aaaaaaaalesha/wdt_agent/documentation/РПЗ. Сторожевой таймер. ИУ8-74 Александров.pdf

Министерство науки и высшего образования Российской Федерации Федеральное государственное бюджетное образовательное учреждение высшего образования
«Московский государственный технический университет имени Н.Э. Баумана
(национальный исследовательский университет)» (МГТУ им. Н.Э. Баумана)
ФАКУЛЬТЕТ | Информатика и системы управления (ИУ)
КАФЕДРА | Информационная безопасность (ИУ8)

## РАСЧЕТНО-ПОЯСНИТЕЛЬНАЯ ЗАПИСКА

## К КУРСОВОМУПРОЕКТУ

## НА ТЕМУ:

## Система восстановления работоспособности терминала самообслуживания

Студент | ИУ8-74 | А. Н. Александров
(Группа) | (Подпись, дата) | (И.О.Фамилия)
Руководитель курсового проекта | А. Г. Рафиков
(Подпись, дата) | (И.О.Фамилия)

Консультант
(Подпись, дата) | (И.О.Фамилия)

Министерство науки и высшего образования Российской Федерации Федеральное государственное бюджетное образовательное учреждение высшего образования
«Московский государственный технический университет имени Н.Э. Баумана (национальный исследовательский университет)» (МГТУ им. Н.Э. Баумана)

УТВЕРЖДАЮ

Заведующий кафедрой ИУ-8
(Индекс)
______________ М.А.Басараб
(И.О.Фамилия)
«_____» сентября 2022 г.

### З А Д А Н И Е

на выполнение курсовой работы

по дисциплине | Аппаратные средства вычислительной техники
Студент группы ИУ8-74
Александров Алексей Николаевич
(Фамилия, имя, отчество)
Тема курсовой работы Разработка системы восстановления работоспособности

Направленность КР (учебная, исследовательская, практическая, производственная, др.)

учебная

Источник тематики (кафедра, предприятие, НИР) | кафедра
График выполнения КР: | 25% к 4 нед., 50% к 7 нед., 75% к 10 нед., 100% к 14 нед.
Оформление курсовой работы:
- Техническое задание.
- Расчетно-пояснительная записка на листах формата А4.
Перечень графического (иллюстративного) материала (чертежи, плакаты, слайды и т.п.)
1. Схема электрическая структурная
2. Схема электрическая принципиальная

Дата выдачи задания « » сентября 2022 г.

Студент | _________________ | А.Н. Александров
| (Подпись, дата) | (И.О.Фамилия)
Руководитель курсовой работы | _________________ | А.Г. Рафиков
| (Подпись, дата) | (И.О.Фамилия)
Примечание: Задание оформляется в двух экземплярах: один выдается студенту, второй хранится на кафедре.

СОДЕРЖАНИЕ

ПРИЛОЖЕНИЕ Г – СХЕМА ЭЛЕКТРИЧЕСКАЯ ПРИНЦИПИАЛЬНАЯ20

ВВЕДЕНИЕ

Мы всегда надеемся, что оборудование и инфраструктура будут работать

чётко, надёжно, и без поломок. Особенно это важно там, где неисправности

приводят к остановке бизнес–процессов и как следствие – финансовым

потерям.

Как минимум, эти потери складываются из оплаты сотрудников за время

простоя (пока они ждут восстановления работы системы), и упущенной за это

время прибыли. К этому можно добавить суммы, затраченные на сам ремонт и

восстановление системы (покупку исправных комплектующих, оплату работ по

установке и замене, и т.п.). Сумма убытков может быть достаточно большой; в

некоторых случаях простой может привести к непоправимым последствиям –

вплоть до исчезновения бизнеса. Это является поводом задуматься о том, как

можно избежать остановки работоспособности.

Сторожевой таймер (от англ. WatchDog Timer) – аппаратно реализованная

схема контроля над зависанием системы. Представляет собой таймер, который

периодически сбрасывается контролируемой системой. Если сброса не

произошло | в | течение | некоторого | интервала | времени, | происходит

принудительная перезагрузка системы.

НАЗНАЧЕНИЕ И ОБЛАСТЬ ПРИМЕНЕНИЯ

Задача системы – восстанавливать работоспособность терминала

самообслуживания и программного обеспечения, запущенного на нём, при

зависаниях для обеспечения её надёжности и безотказной работы. В случае

непредвиденной ошибки и зависания ОС и ПО, сторожевой таймер не получит

сигнала обновления таймера и выполнит принудительную перезагрузку

системы или перезапуск приложения соответственно.

Областью применения является терминал самообслуживания. Это

специализированное электронно-механическое устройство, которое позволяет

автоматизировать процессы. С помощью таких устройств пользователь может

без участия сотрудника оплатить покупки, получить посылку, пройти через

турникет или оплатить услуги. Примеры аппаратов самообслуживания: кассы

самообслуживания, постаматы, информационные терминалы и вендинговые

автоматы (см. рисунок 1).

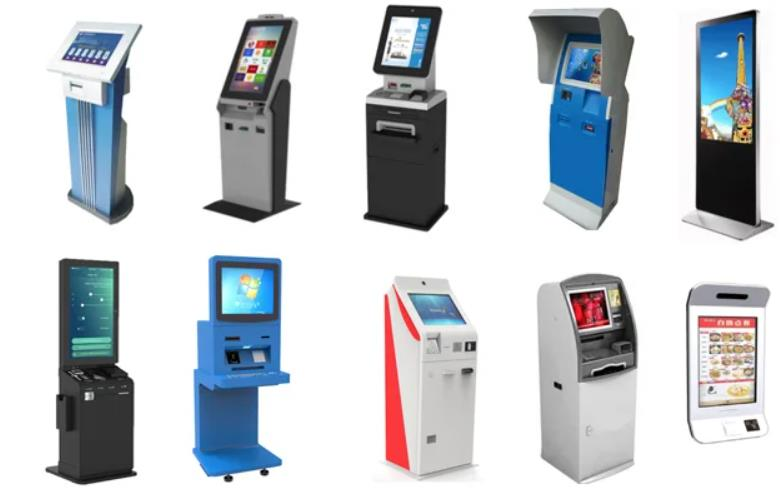
[picture p2: figure]

Рисунок 1 – Примеры терминалов самообслуживания

Основная цель создания системы – разработка механизма безопасности,

который позволяет вернуть терминал самообслуживания и программное

обеспечение, запущенное на нём, в рабочий режим случае сбоя для повышения

её надёжности и безотказной работы.

ТЕХНИЧЕСКИЕ ХАРАКТЕРИСТИКИ

### 1 Аппаратная часть

### 1.1 Описание схемы

В ходе выполнения курсового проекта в соответствии с техническим

заданием были спроектированы схема электрическая структурная, схема

электрическая принципиальная и перечень элементов (ГОСТ 2.701 - 84). Схемы

можно видеть на рисунках 2 и 3, приложениях В и Г, а также в приложенной

документации к курсовому проекту. Перечень элементов – в приложении Ж и в

документации.

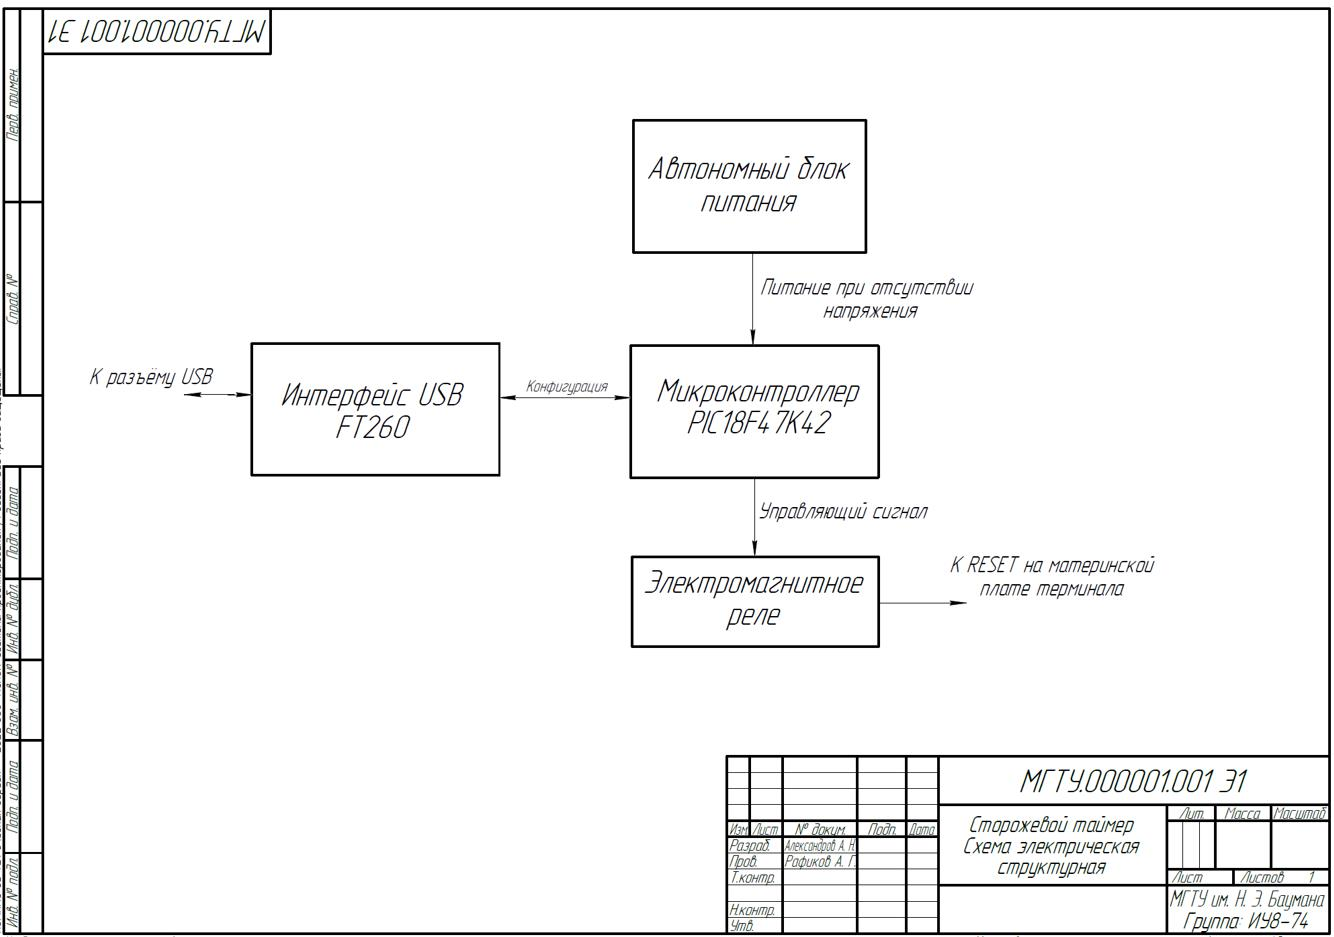
[picture p3: figure]

Рисунок 2 – Схема электрическая структурная (Э1)

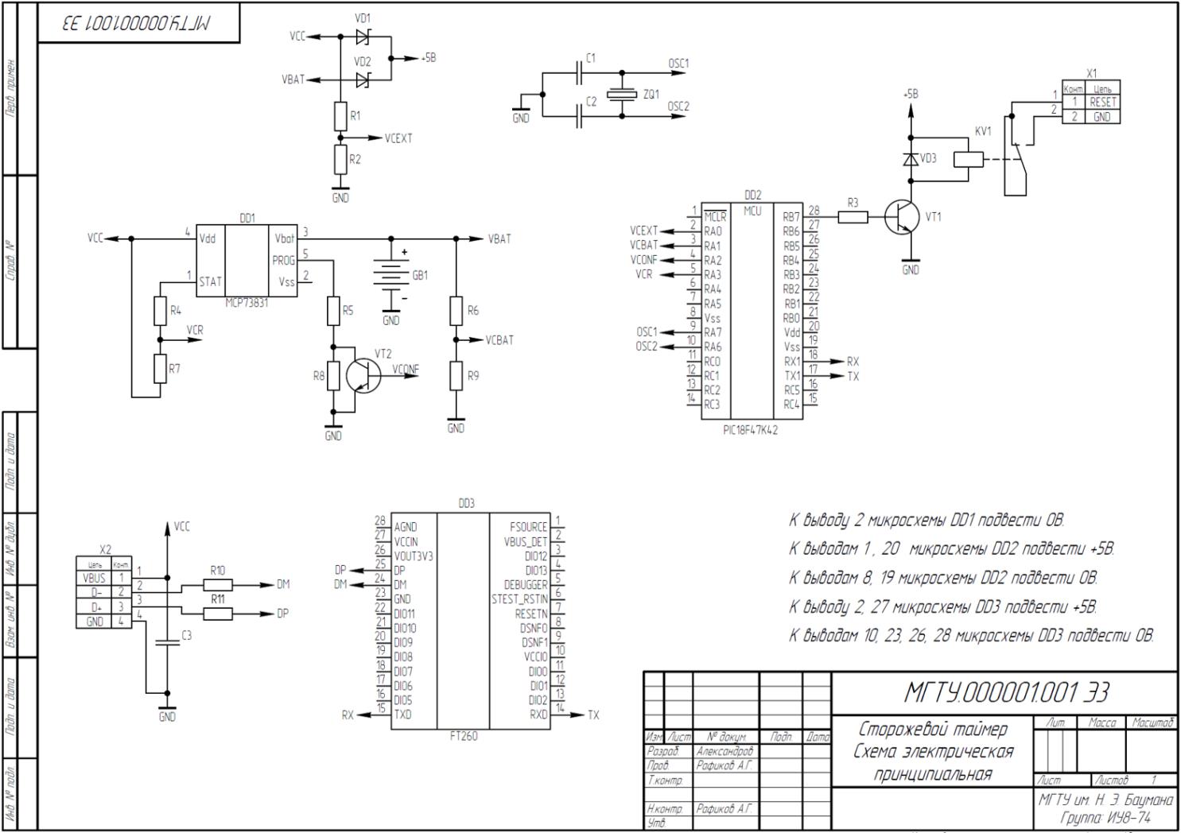
[picture p4: figure]

Рисунок 3 – Схема электрическая принципиальная (Э3)

В предложенной схеме в качестве основных компонентов выступают:

- микроконтроллер PIC18F47К42;
- герконовое реле EDR301A0500 для передачи сигнала RESET на

материнскую плату терминала самообслуживания и перезапуска

ОС;

- микросхема | FT260 | как | интерфейс | взаимодействия

микроконтроллера с USB;

- микросхема контроллера заряда MCP73831 для автономного блока

питания.

Также на схеме присутствуют элемент питания, NPN-транзисторы, диоды

Шоттки, кварцевый резонатор, а также резисторы и конденсаторы.

### 1.2 Обоснование выбора контроллера

В | качестве | микроконтроллера | был | выбран | восьмиразрядный

микроконтроллер PIC18F47К42. Некоторые технические характеристики:

- рабочая скорость: до 64 МГц;
- 128 Кб флеш-памяти, 8 Кб SRAM;
- диапазон рабочих напряжений: от 2.3 В до 5.5 В;
- диапазон рабочих температур: от -40°C до 85°C;
- оптимизированная компилятором C архитектура RISC.

Ключевыми факторами выбора можно назвать относительно низкую

стоимость, запас по программной памяти, скорость работы, что является

немаловажными критериями для данного класса устройств.

### 1.3 Обоснование выбора резисторов и конденсаторов

Элементы активного и реактивного сопротивления, включенные в схему,

выбраны из-за их невысокой стоимости. Также элементы SMD обладают рядом

существенных преимуществ, среди которых:

1. лучшая устойчивость к механическим поломкам вследствие вибрации;
2. небольшие погрешности при монтаже исправляются автоматически

поверхностным натяжением расплавленного олова или свинца;

3. нет необходимости сверлить отверстия и в том числе, как следствие,

более низкая начальная стоимость производства (экономический

| эффект);
4. небольшие размеры;
5. из-за малых размеров и монтирования в оной плоскости облегчается

двухслойная разводка.

### 1.4 Печатная плата и сборочный чертёж

Исходя из специфики устройства и его установки, был выбран корпус

G535B-2% — пластиковый корпус из ABS пластика, чертёж которого

представлен на рисунке 4. | Габаритные размеры составляют: по длине 114 мм,
по ширине 35,7 мм и по высоте 25,8 мм. | Размеры корпуса, расположение

диагональных отверстий и их диаметр были использованы для проектирования

и создания печатной платы, которая сможет быть в нём размещена.

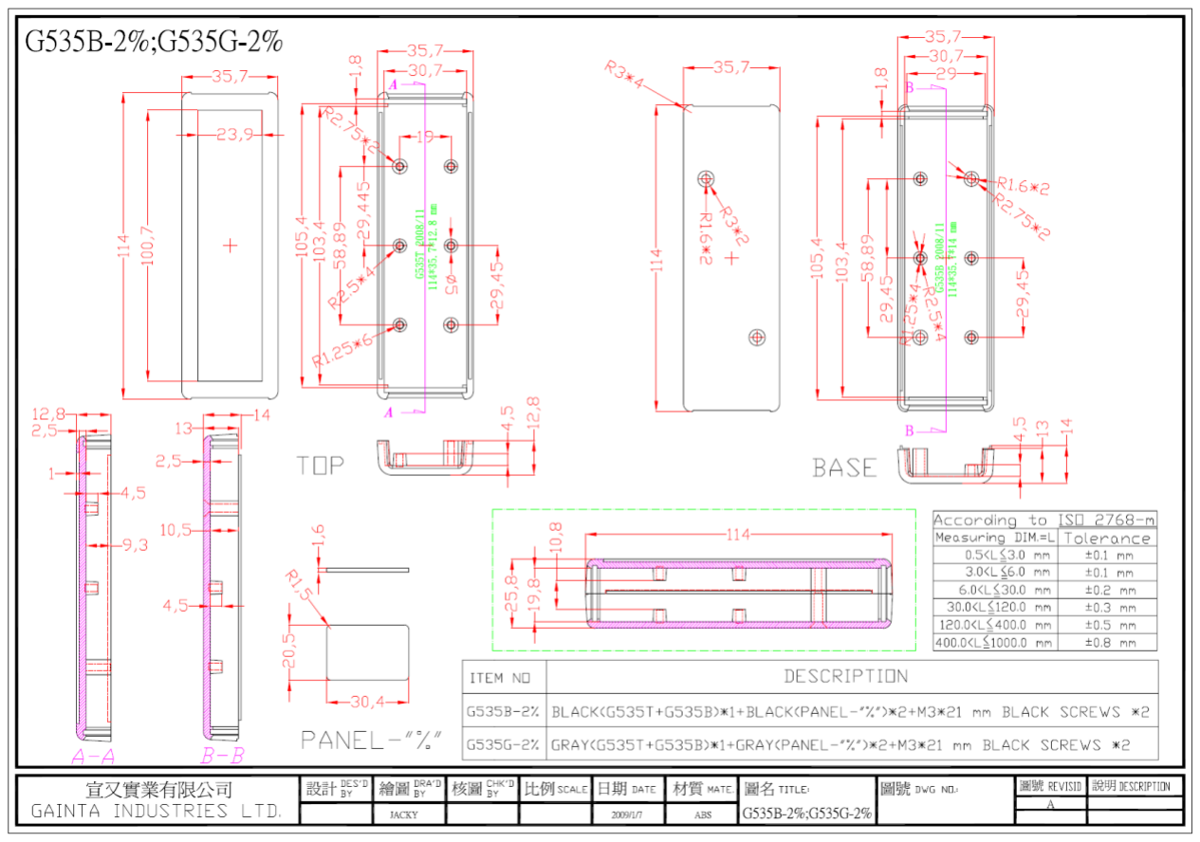
[picture p5: figure]

Рисунок 4 – Чертёж корпуса G535B-2%

Для проектирование и разводки печатной платы было использовано

САПР Autodesk Eagle, который предоставляет редактор схем и печатных плат с

невысоким порогом вхождения и простым и понятным интерфейсом. Далее

были выделены необходимые слои: верхний слой, нижний слой и слой

переходных отверстий, которые были перенесены в КОМПАС для создания

чертежа печатной платы в соответствии с ГОСТ (см рисунки 5 и 6).

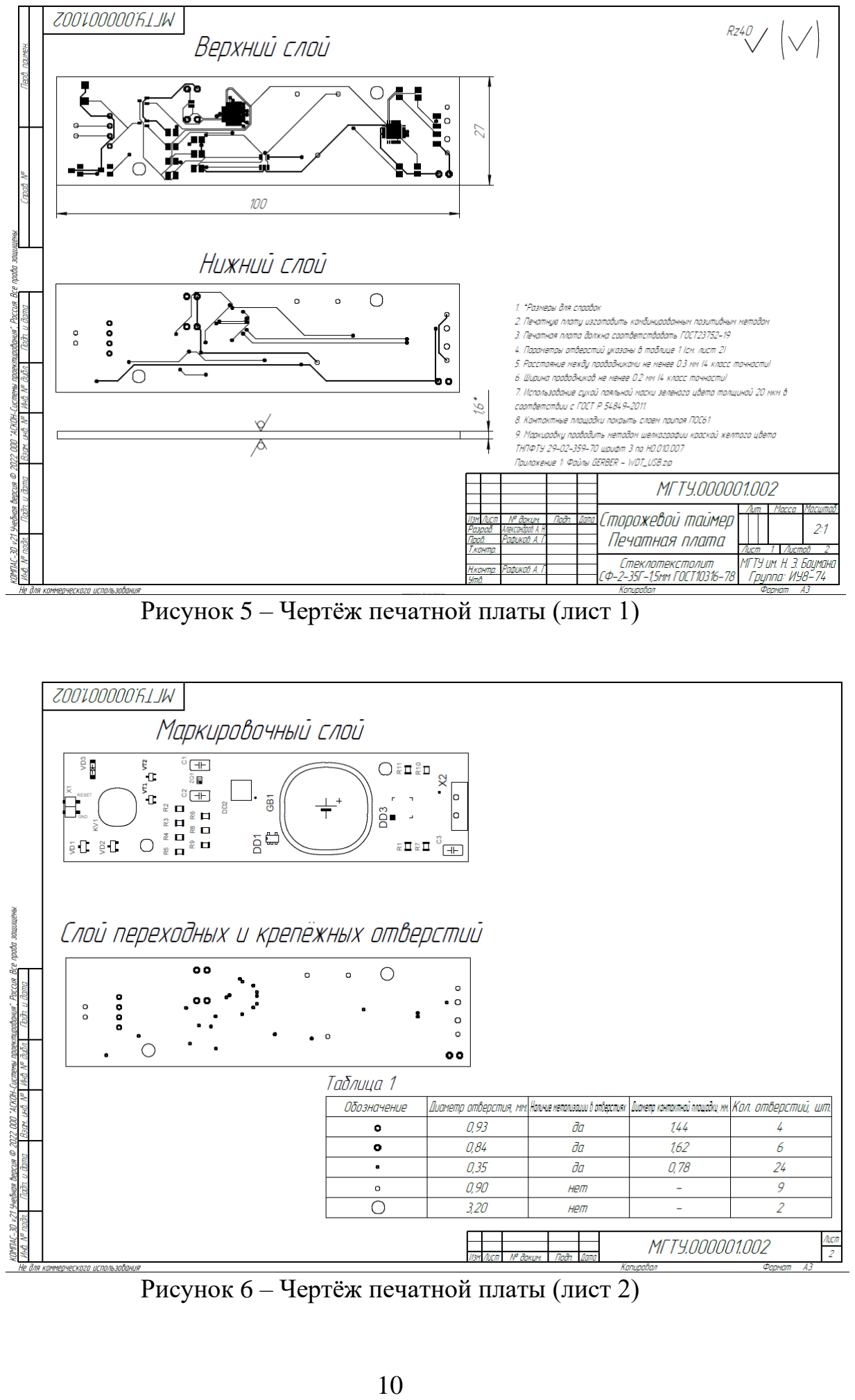
[picture p6: page 10]

Рисунок 5 – Чертёж печатной платы (лист 1)

Рисунок 6 – Чертёж печатной платы (лист 2)

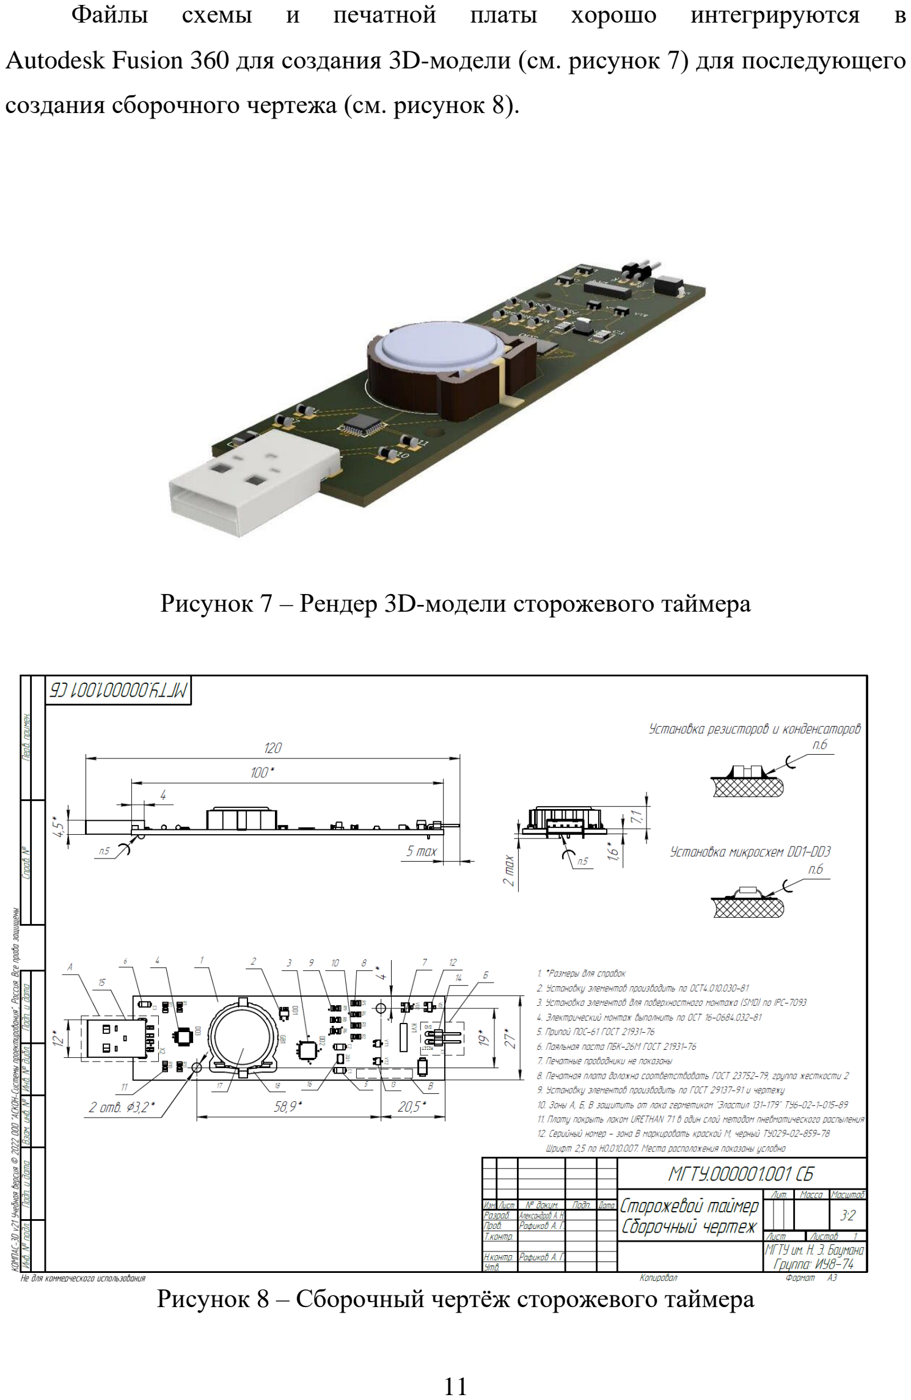
[picture p7: page 11]

Файлы | схемы | и | печатной | платы | хорошо | интегрируются | в

Autodesk Fusion 360 для создания 3D-модели (см. рисунок 7) для последующего

создания сборочного чертежа (см. рисунок 8).

Рисунок 7 – Рендер 3D-модели сторожевого таймера

Рисунок 8 – Сборочный чертёж сторожевого таймера

### 2 Программная часть

### 2.1 Описание программной части

Программная часть опытного образца представляет собой программное

обеспечение, которое также реализует работу с микроконтроллером.

Программный агент, будучи подключенным к сторожевому таймеру, посылает

сигналы сброса, в случае, когда эти сигналы не поступают, происходит

переключение реле и подача напряжения на сигнал RESET на материнской

плате.

### 2.2 Программный агент для терминала самообслуживания

Для создания программы-агента, работающего с моделью сторожевым

таймером был использован язык программирования Python. Десктопное

приложение работает под ОС Windows, которая распространена в данной

области | применения. | Программа-агент | осуществляет | подключение | к
устройству | по | COM-порту, | конфигурирование | таймера | и | занесение
приложений | в | список | отслеживаемых | процессов, | которые | следует

перезапускать в случае зависания (см. рисунок 9).

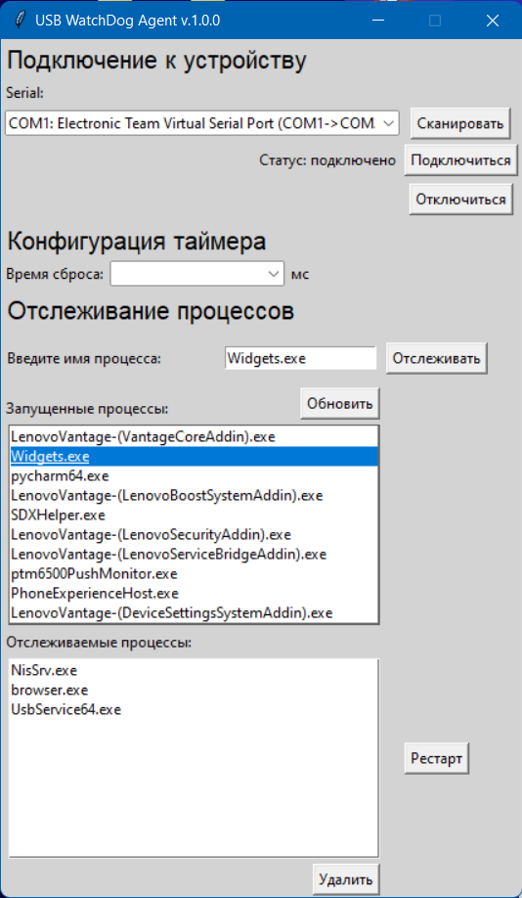
[picture p8: figure]

Рисунок 9 – Окно программы WatchDog Agent v.1.0.0

### 2.3 Программное обеспечение для сторожевого таймера

Исходным | языком | программирования | для | сторожевого | таймера

является Си. Программа обеспечивает взаимодействие с программой-агентом,

получение конфигурационных данных от него и переключение реле при

истечении таймаута и необходимости передачи управляющего сигнала RESET

на соответствующий пин. Моделирование производилось в среде Proteus (см.

рисунок 10). Создание пары виртуального COM-порта велось через Virtual

Driver Pro (см. рисунок 11). Таким образом можно производить подключение

программно к одному и тому же COM-порту.

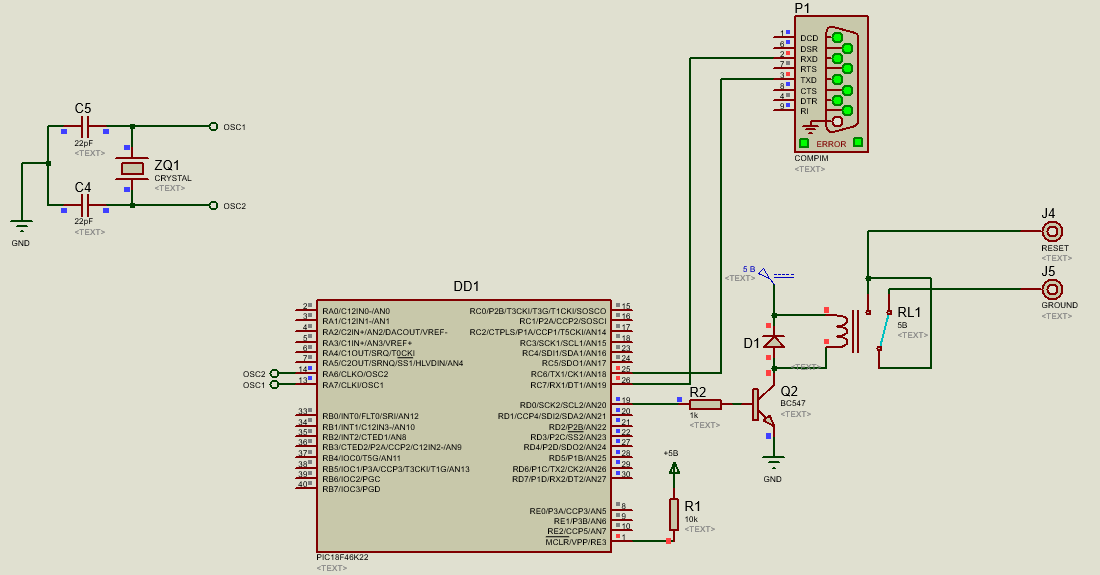
[picture p9: figure]

Рисунок 10 – Моделирование сторожевого таймера в среде Proteus

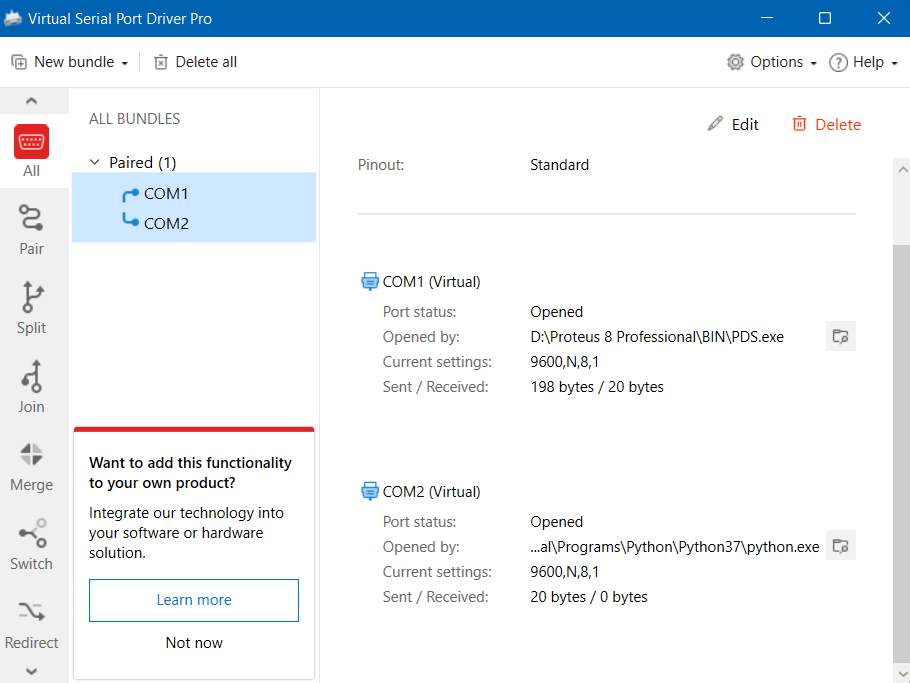
[picture p10: figure]

Рисунок 11 – Создание пары виртуального COM-порта

### 3 Испытания модели

Для проверки работоспособности устройства предлагается запустить

собранную модель (см. рисунок 12).

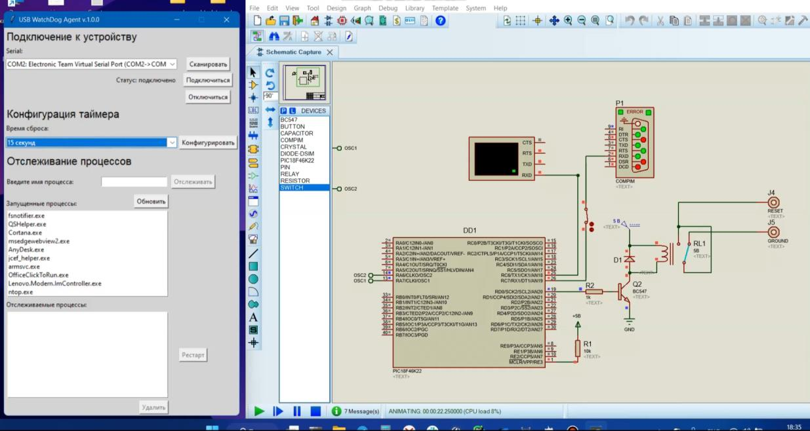
[picture p11: figure]

Рисунок 12 – Испытание модели сторожевого таймера в среде Proteus

При симуляции были проверены следующие параметры программы,

указанные в таблице 1.

Таблица 1 – Тестирование сторожевого таймера

Направление теста | Результат тестирования
Запуск модели без программы-агента | ✔ Тест пройден
Запуск агента без запуска модели | ✔ Тест пройден
Подключение агента к модели по COM-порту | ✔ Тест пройден
Передача конфигурации таймера | ✔ Тест пройден
Поиск/добавление/удаление приложений в списке отслеживаемых | ✔ Тест пройден
Перезапуск приложений по кнопке и по таймауту зависания | ✔ Тест пройден
Переключение реле при таймауте сторожевого таймера | ✔ Тест пройден

ОЖИДАЕМЫЕ ТЕХНИКО-ЭКОНОМИЧЕСКИЕ ПОКАЗАТЕЛИ

### 1.1 Экономические показатели

Из-за малого масштаба продукта и рынка спроса на данный продукт,

технико-экономические показатели не являются решающим фактором при его

создании, вследствие чего посчитать экономические показатели не является

возможным.

### 1.2 Технические показатели

Технические показатели являются сильной стороной изделия. Функции

программной части позволяют обеспечить работу ПО в автономном режиме

при подключенном таймере к USB порту компьютера.

ЗАКЛЮЧЕНИЕ

В результате проделанной работы было спроектировано устройство для

восстановления работоспособности терминала самообслуживания. В ходе

выполнения курсовой работы были получены необходимые навыки для

проектирования, | моделирования | и | создания | функциональных | систем,

оформления функциональной, принципиальной схем и документации в

соответствии с ГОСТ.

Было получено понимание технологического процесса, необходимого для

изготовления функционального устройства, которое обеспечивают работу в

соответствии с заданными требованиями.

ПРИЛОЖЕНИЕ А – ТЕКСТ ПРОГРАММЫ

См. Текст программы

ПРИЛОЖЕНИЕ Б – РУКОВОДСТВО ОПЕРАТОРА

См. Руководство оператора

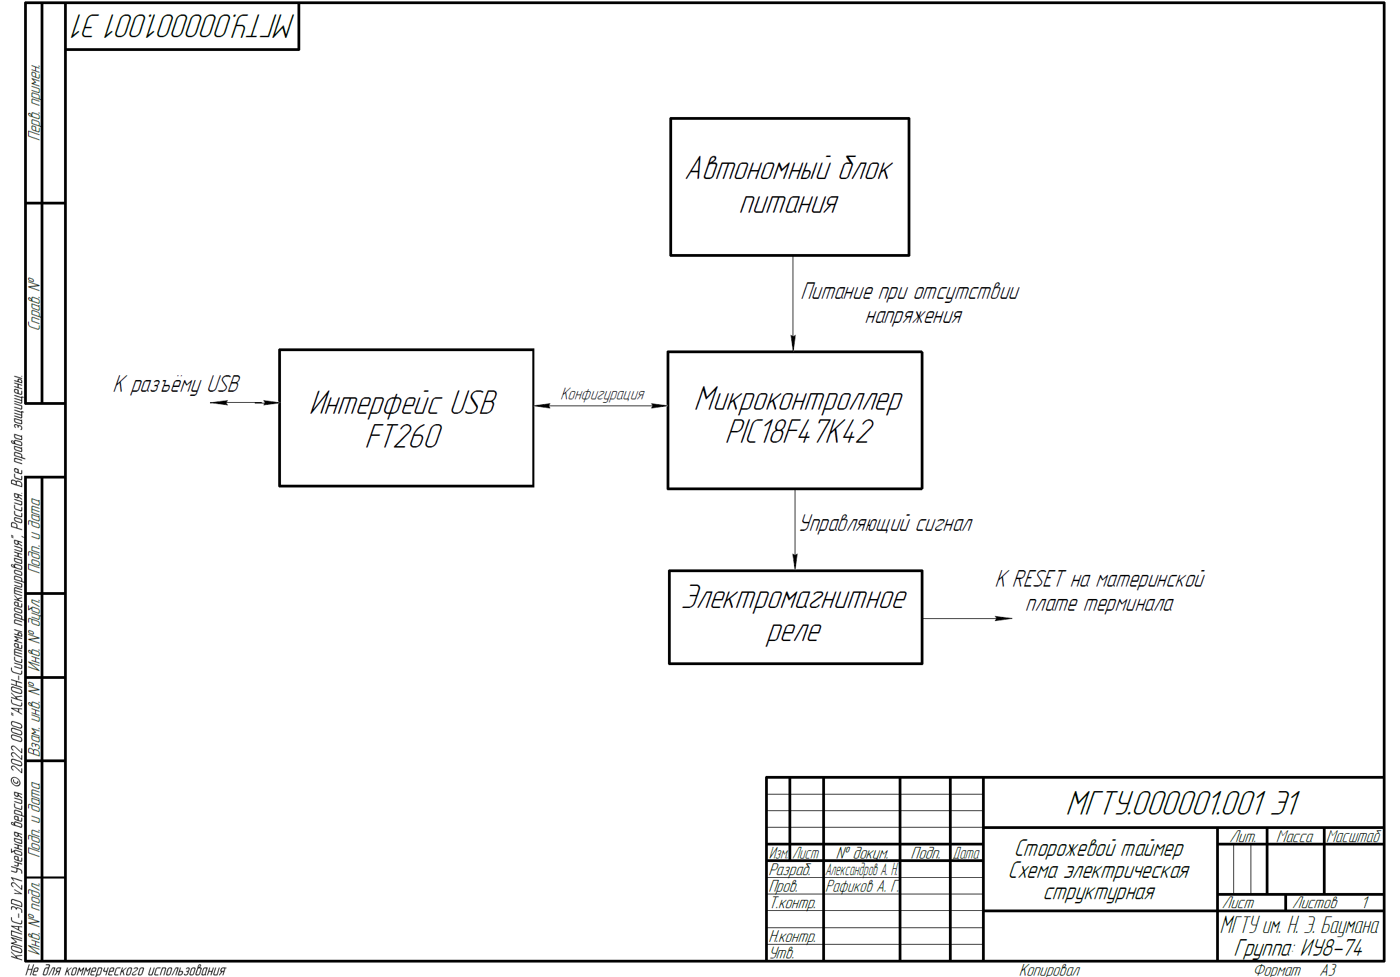
[picture p12: page 19]

ПРИЛОЖЕНИЕ В – СХЕМА ЭЛЕКТРИЧЕСКАЯ СТРУКТУРНАЯ

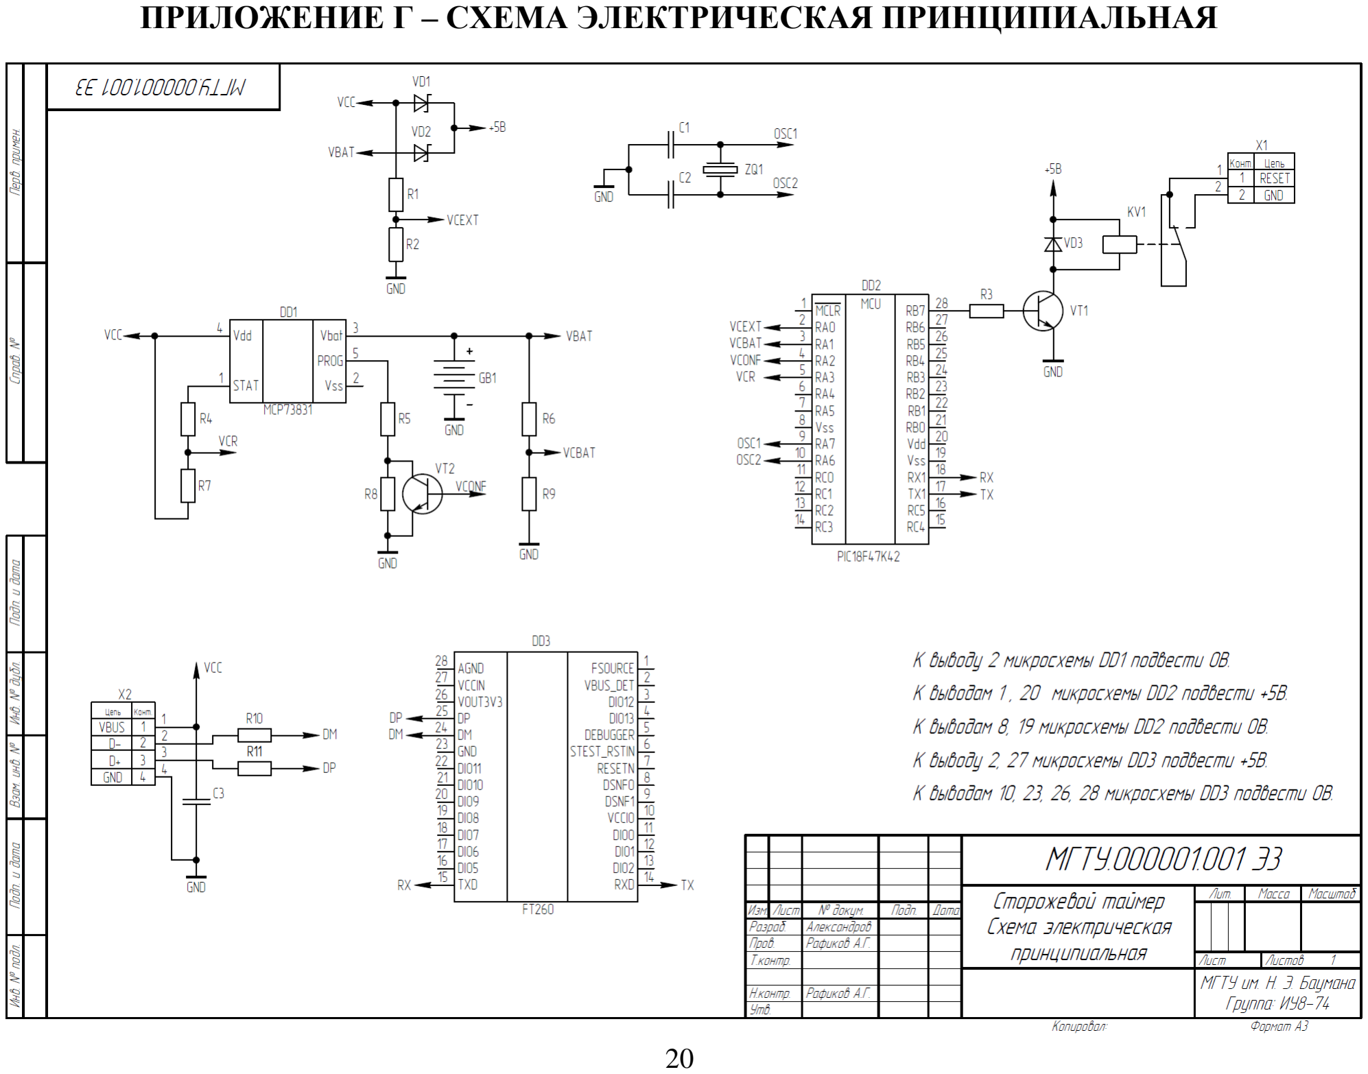
[picture p13: page 20]

ПРИЛОЖЕНИЕ Г – СХЕМА ЭЛЕКТРИЧЕСКАЯ ПРИНЦИПИАЛЬНАЯ

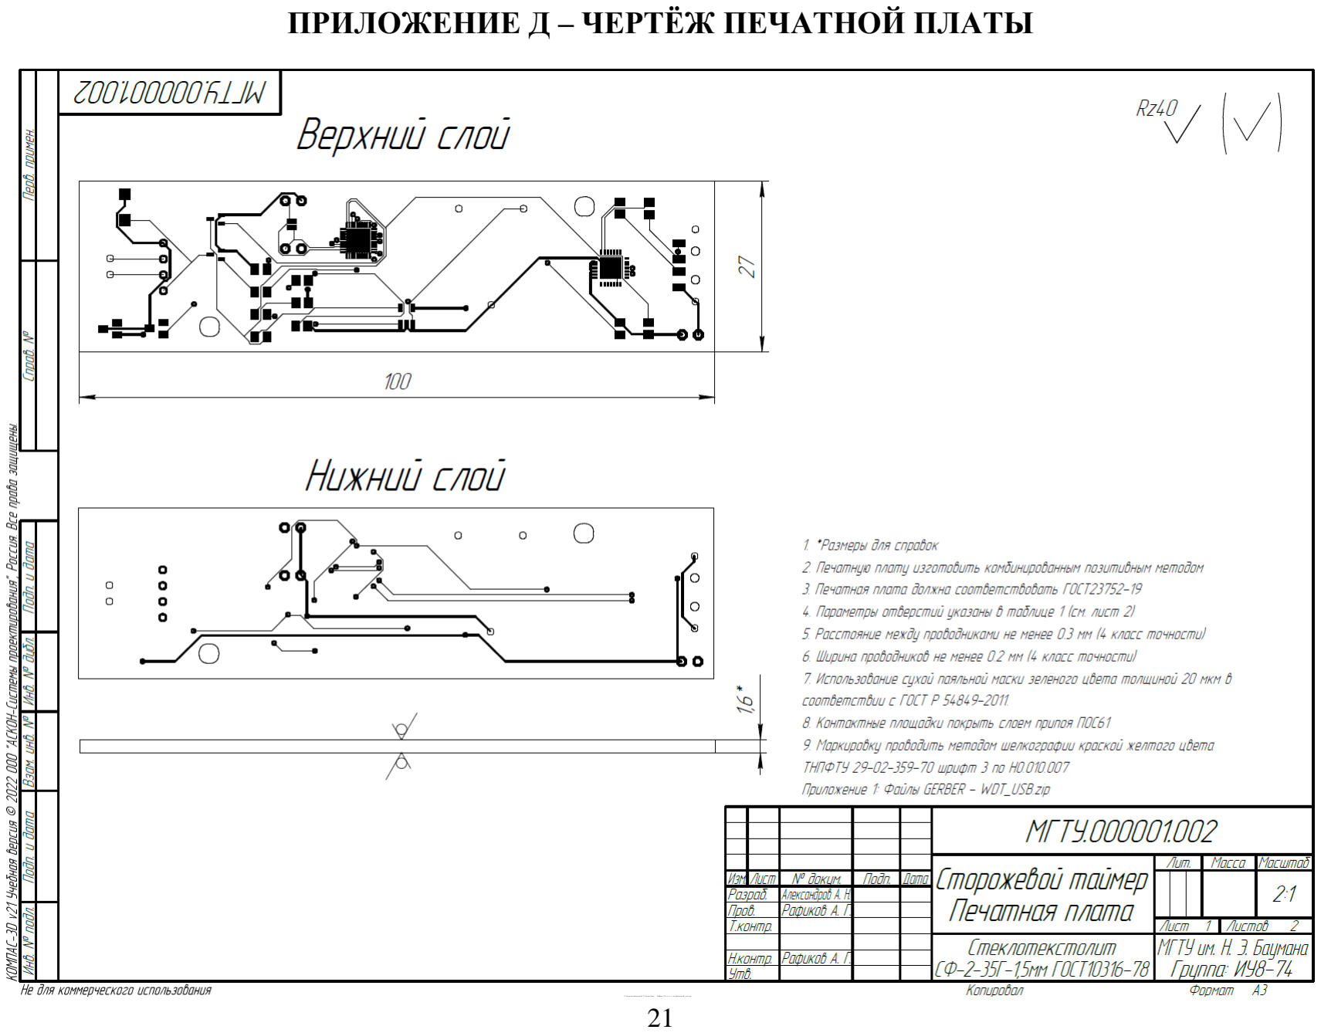
[picture p14: page 21]

ПРИЛОЖЕНИЕ Д – ЧЕРТЁЖ ПЕЧАТНОЙ ПЛАТЫ

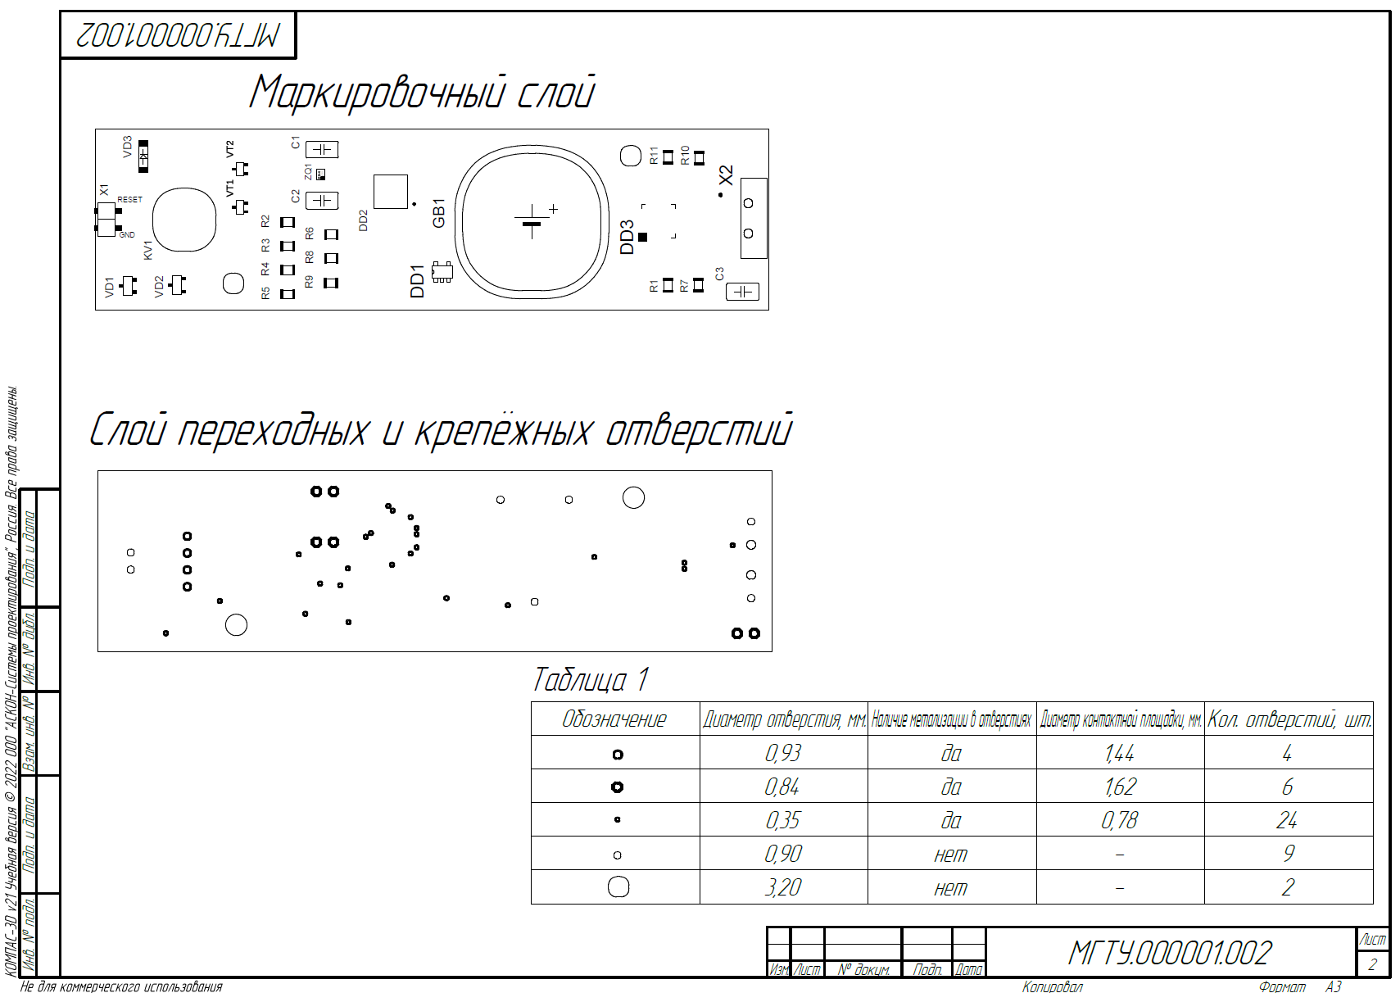
[picture p15: page 22]
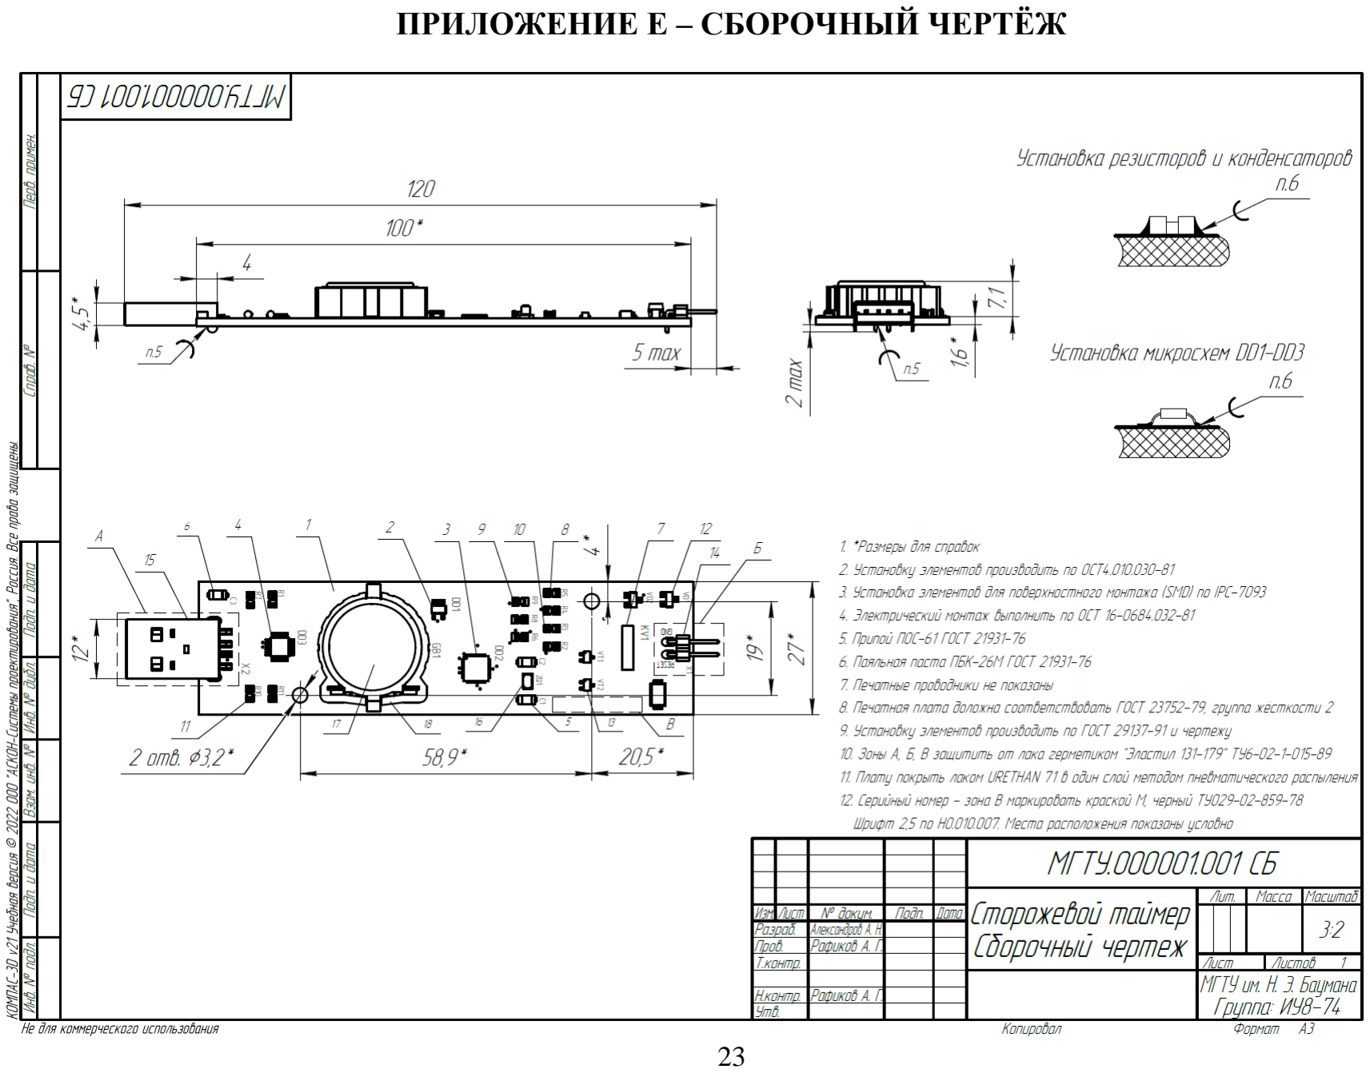
[picture p16: page 23]

ПРИЛОЖЕНИЕ Е – СБОРОЧНЫЙ ЧЕРТЁЖ

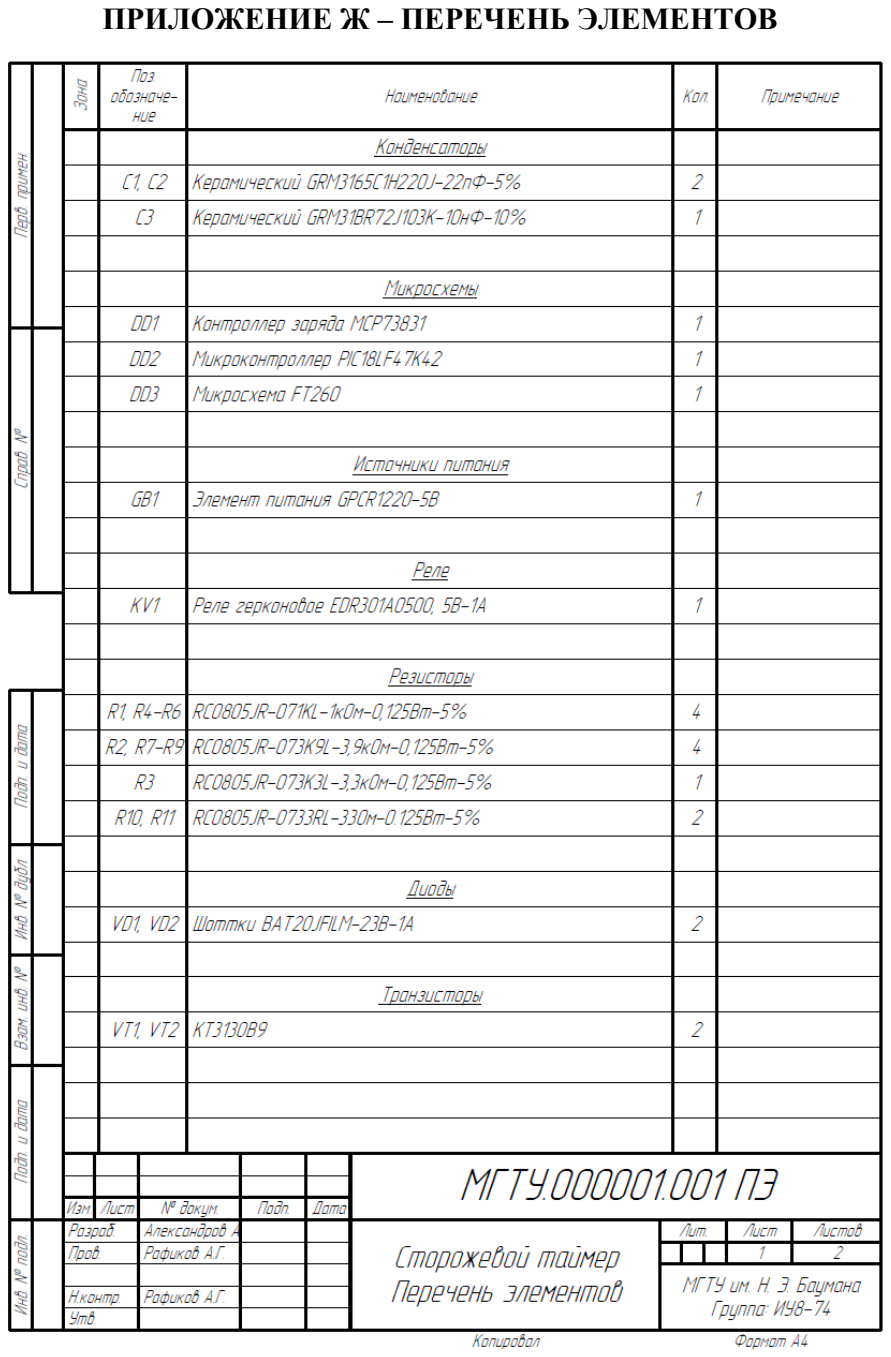
[picture p17: page 24]

ПРИЛОЖЕНИЕ Ж – ПЕРЕЧЕНЬ ЭЛЕМЕНТОВ

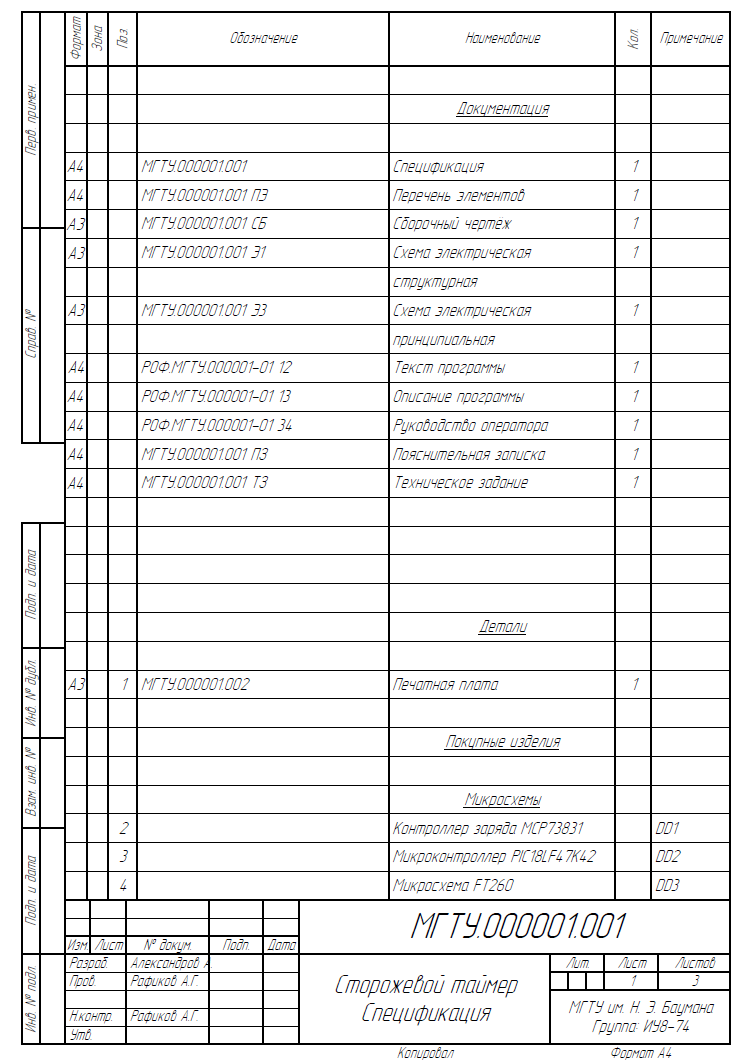
[picture p18: page 25]

ПРИЛОЖЕНИЕ З – СПЕЦИФИКАЦИЯ

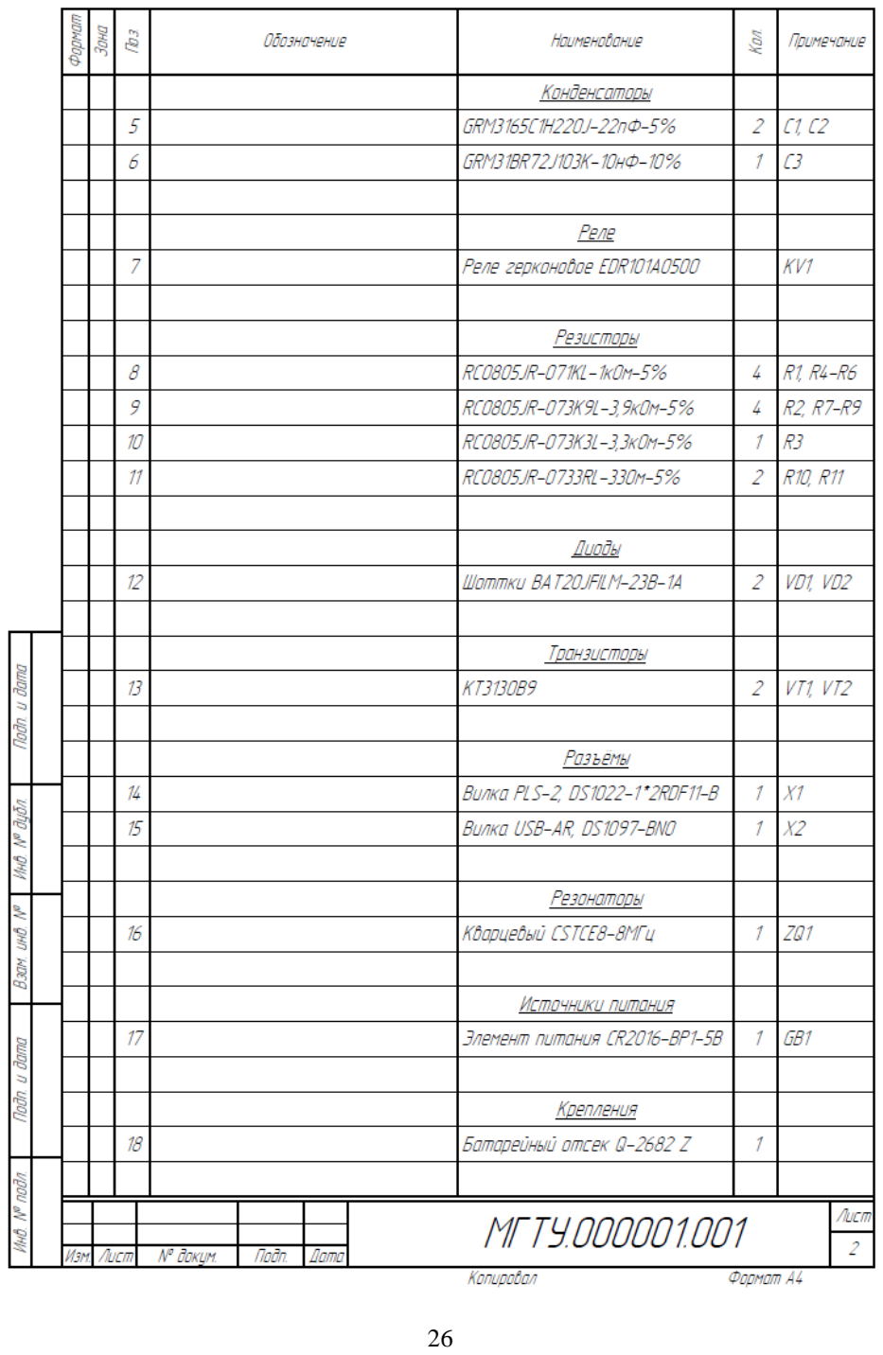
[picture p19: page 26]
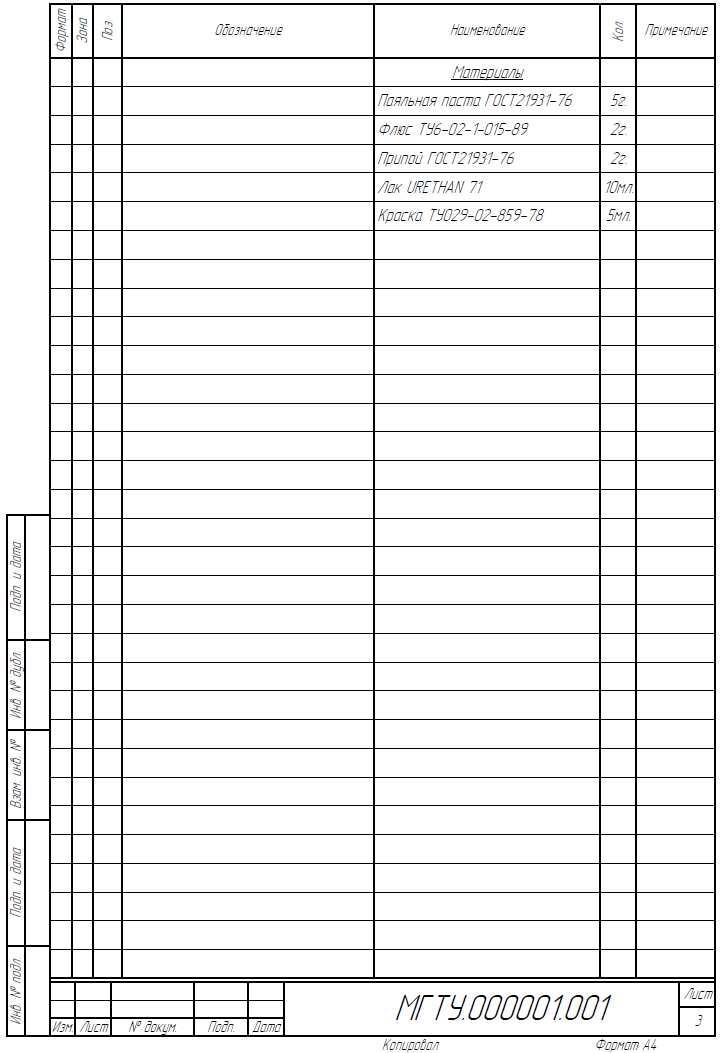
[picture p20: page 27]
