aaaaaaaalesha/wdt_agent/documentation/СА программы агента.pdf

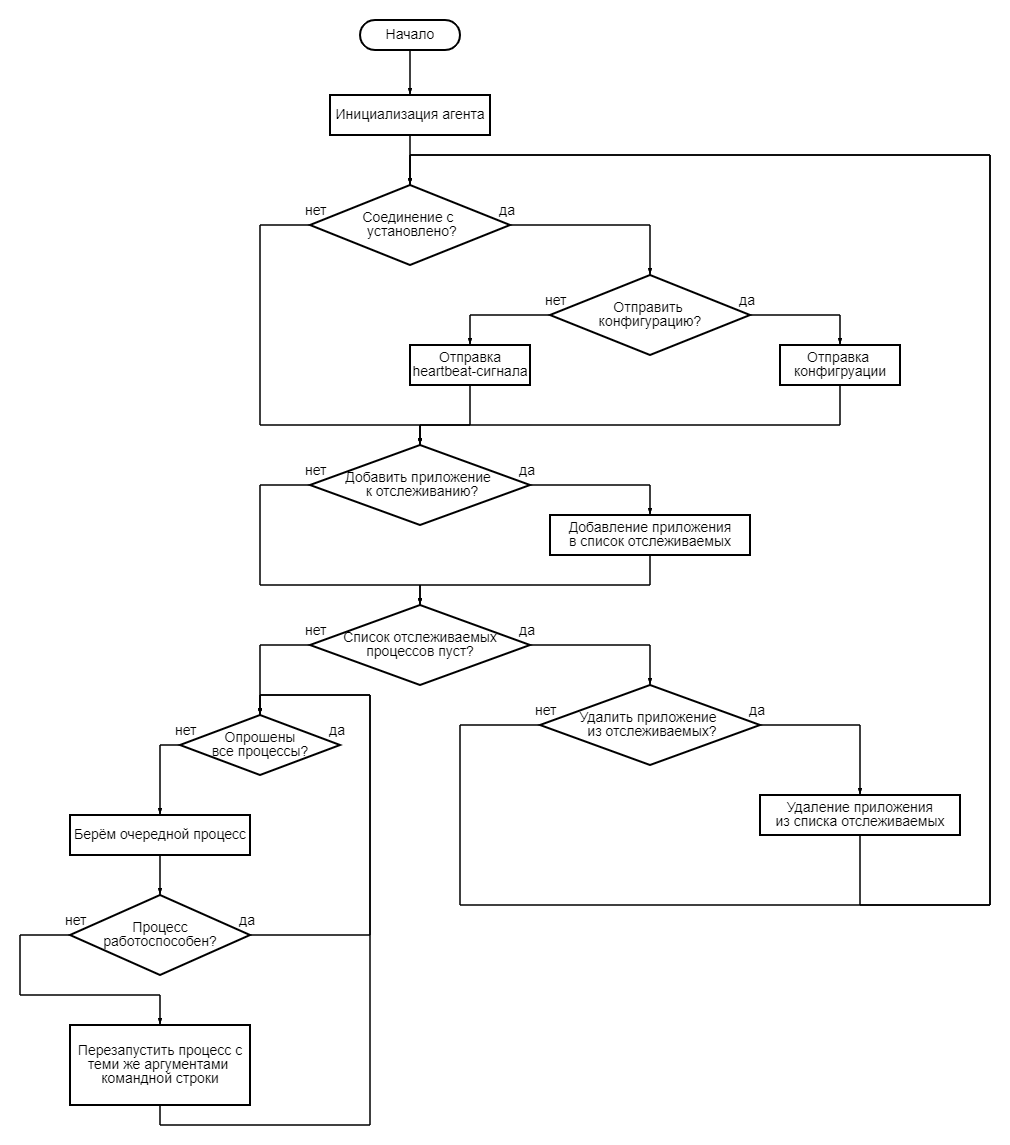
[picture p24: figure]

Н.контр. | Рафиков А.Г.
Утв.
| | | | МГТУ.000001.001 СА
| | | | Сторожевой таймер Схема алгоритма программы агента | Лит. | Масса | Масштаб
Изм. Лист | № докум. | Подп. | Дата
Разраб. | Александров
| Пров. | Рафиков А.Г.
Т.контр. | | | | Лист | Листов 1
| | | | МГТУ им. Н. Э. Баумана Группа: ИУ8-74
Копировал: | Формат А4
