aaaaaaaalesha/wdt_agent/documentation/Спецификация. Сторожевой таймер. ИУ8-74 Александров.pdf

Изм. Лист | | № докум. | Подп. | Дата
| | Разраб. | Александров А. | | Сторожевой таймер Спецификация
Пров. | Рафиков А.Г. | | | | | 1 3
Н.контр. | Рафиков А.Г.
Утв.
Копировал | Формат А4

МГТУ им. Н. Э. Баумана
Группа: ИУ8-74
Лит. | Лист | Листов Инв. № подл. Подп. и дата Взам. инв. № Инв. № дубл. Подп. и дата Справ. № Перв. примен. | Формат | Зона | Поз. | Обозначение | Наименование | Кол. | Примечание

Документация

А4 | МГТУ.000001.001 | Спецификация | 1
А4 | МГТУ.000001.001 ПЭ | Перечень элементов | 1
А3 | МГТУ.000001.001 СБ | Сборочный чертёж | 1
А3 | МГТУ.000001.001 Э1 | Схема электрическая | 1
| | структурная
А3 | МГТУ.000001.001 Э3 | Схема электрическая | 1
| | принципиальная
А4 | РОФ.МГТУ.000001-01 12 | Текст программы | 1
А4 | РОФ.МГТУ.000001-01 13 | Описание программы | 1
А4 | РОФ.МГТУ.000001-01 34 | Руководство оператора | 1
А4 | МГТУ.000001.001 ПЗ | Пояснительная записка | 1
А4 | МГТУ.000001.001 ТЗ | Техническое задание | 1

Детали

А3 | 1 | МГТУ.000001.002 | Печатная плата | 1
| | | Покупные изделия
| Микросхемы
2 | Контроллер заряда MCP73831 | | DD1
3 | Микроконтроллер PIC18LF47K42 | | DD2
4 | Микросхема FT260 | | DD3
| | МГТУ.000001.001

Изм. Лист | № докум. | Подп. | Дата

# МГТУ.000001.001

Лист Инв. № подл. Подп. и дата Взам. инв. № Инв. № дубл. Подп. и дата | 2 Формат | Зона | Поз. | Обозначение | Наименование | Кол. | Примечание
| Конденсаторы
5 | GRM3165C1H220J-22пФ-5% | 2 | С1, C2
6 | GRM31BR72J103K-10нФ-10% | 1 | С3
| Реле
7 | Реле герконовое EDR101A0500 | KV1
| Резисторы
8 | RC0805JR-071KL-1кОм-5% | 4 | R1, R4-R6
9 | RC0805JR-073K9L-3,9кОм-5% | 4 | R2, R7-R9
10 | RC0805JR-073K3L-3,3кОм-5% | 1 | R3
11 | RC0805JR-0733RL-33Ом-5% | 2 | R10, R11
| Диоды
12 | Шоттки BAT20JFILM-23B-1A | 2 | VD1, VD2
| Транзисторы
13 | КТ3130В9 | 2 | VT1, VT2
| Разъёмы
14 | Вилка PLS-2, DS1022-1*2RDF11-B | 1 | X1
15 | Вилка USB-AR, DS1097-BN0 | 1 | X2
| Резонаторы
16 | Кварцевый CSTCE8-8МГц | 1 | ZQ1
| Источники питания
17 | Элемент питания CR2016-BP1-5В | 1 | GB1
| Крепления
18 | Батарейный отсек Q-2682 Z | 1

Изм. Лист | № докум. | Подп. | Дата

# МГТУ.000001.001

Лист Инв. № подл. Подп. и дата Взам. инв. № Инв. № дубл. Подп. и дата | 3 Формат | Зона | Поз. | Обозначение | Наименование | Кол. | Примечание

Материалы
Паяльная паста ГОСТ21931-76 | 5г.
Флюс ТУ6-02-1-015-89 | 2г.
Припой ГОСТ21931-76 | 2г.
Лак URETHAN 71 | 10мл.
Краска ТУ029-02-859-78 | 5мл.
