aaaaaaaalesha/wdt_agent/documentation/3d_model_wdt.png

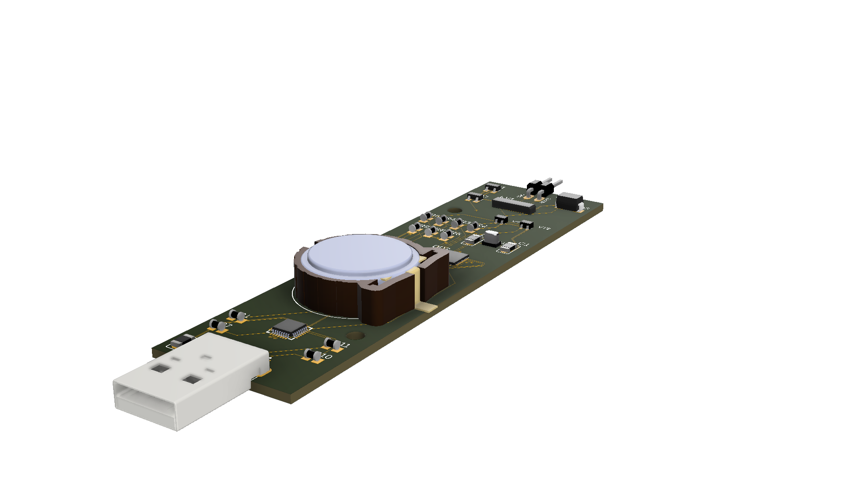
documentation/3d_model_wdt.png
