aaaaaaaalesha/wdt_agent/documentation/block_scheme_timer.png

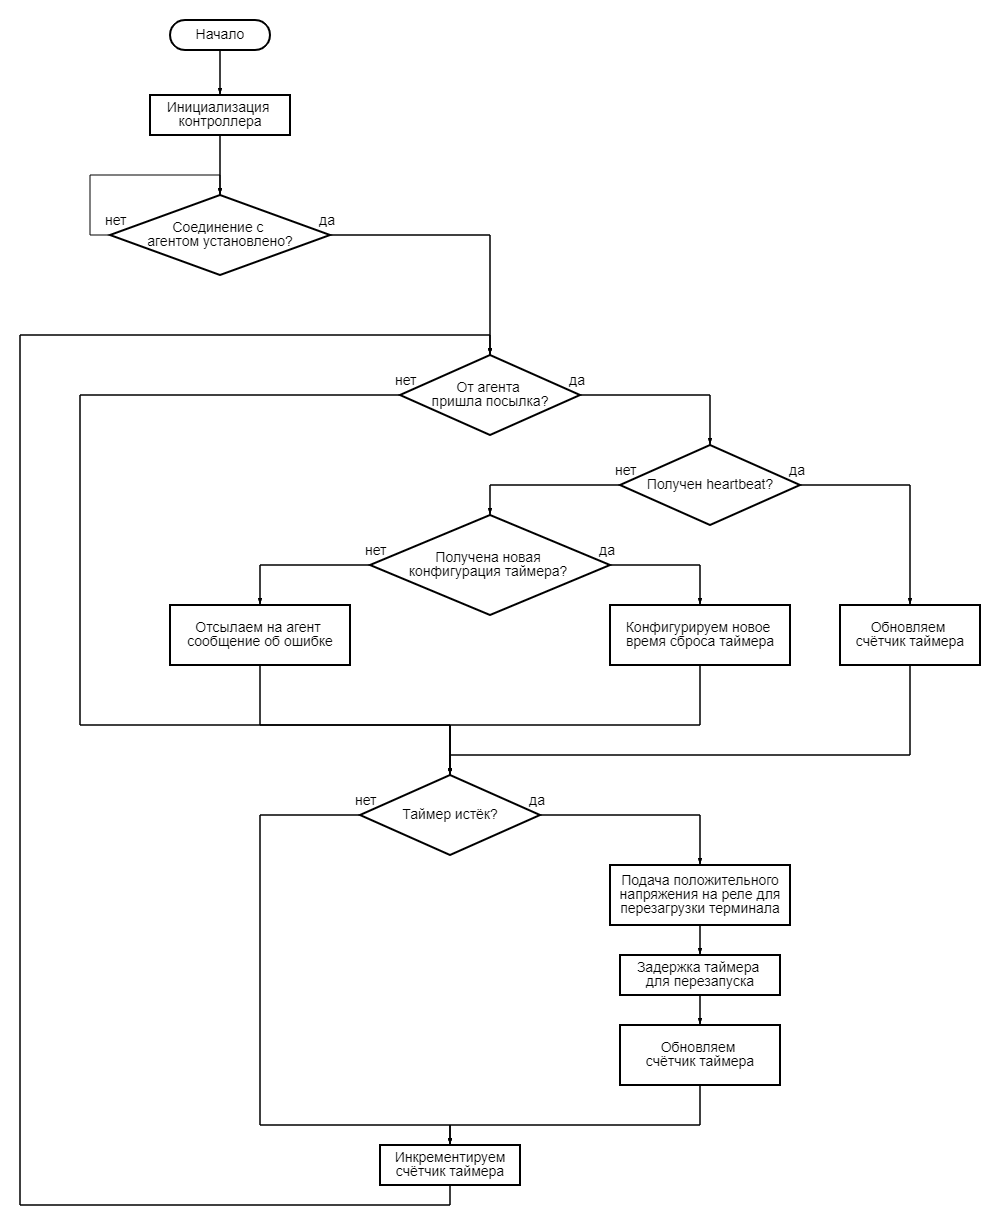
documentation/block_scheme_timer.png
