aaaaaaaalesha/wdt_agent/documentation/Э3. Сторожевой таймер. ИУ8-74 Александров.pdf

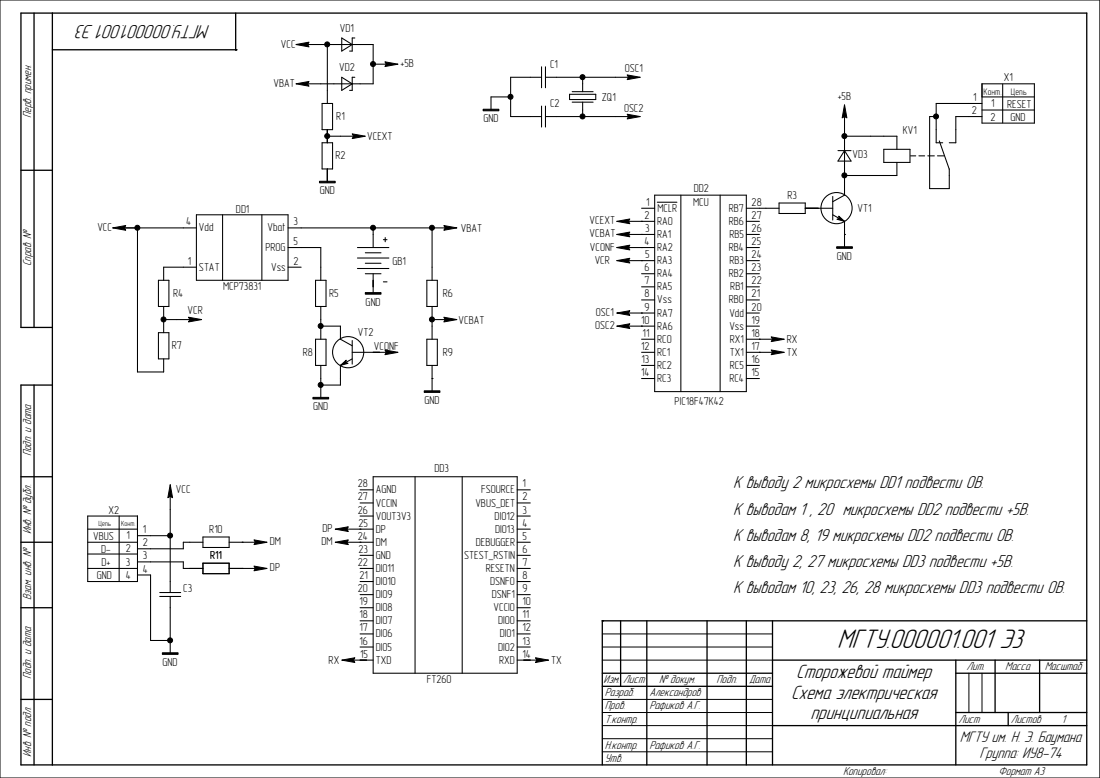
[picture p27: page 1]

Конт. | Цепь
1 | RESET
2 | GND

Цепь | Конт.
VBUS | 1
D- | 2
D+ | 3
GND | 4

МГТУ.000001.001 Э3
Сторожевой таймер Схема электрическая принципиальная | Лит. | Масса | Масштаб

Разраб. | Александров
Пров. | Рафиков А.Г.
Т.контр. | | Лист | Листов 1

МГТУ им. Н. Э. Баумана Группа: ИУ8-74

Н.контр. | Рафиков А.Г.
Утв.
