aaaaaaaalesha/wdt_agent/documentation/Корпус-g535b.pdf

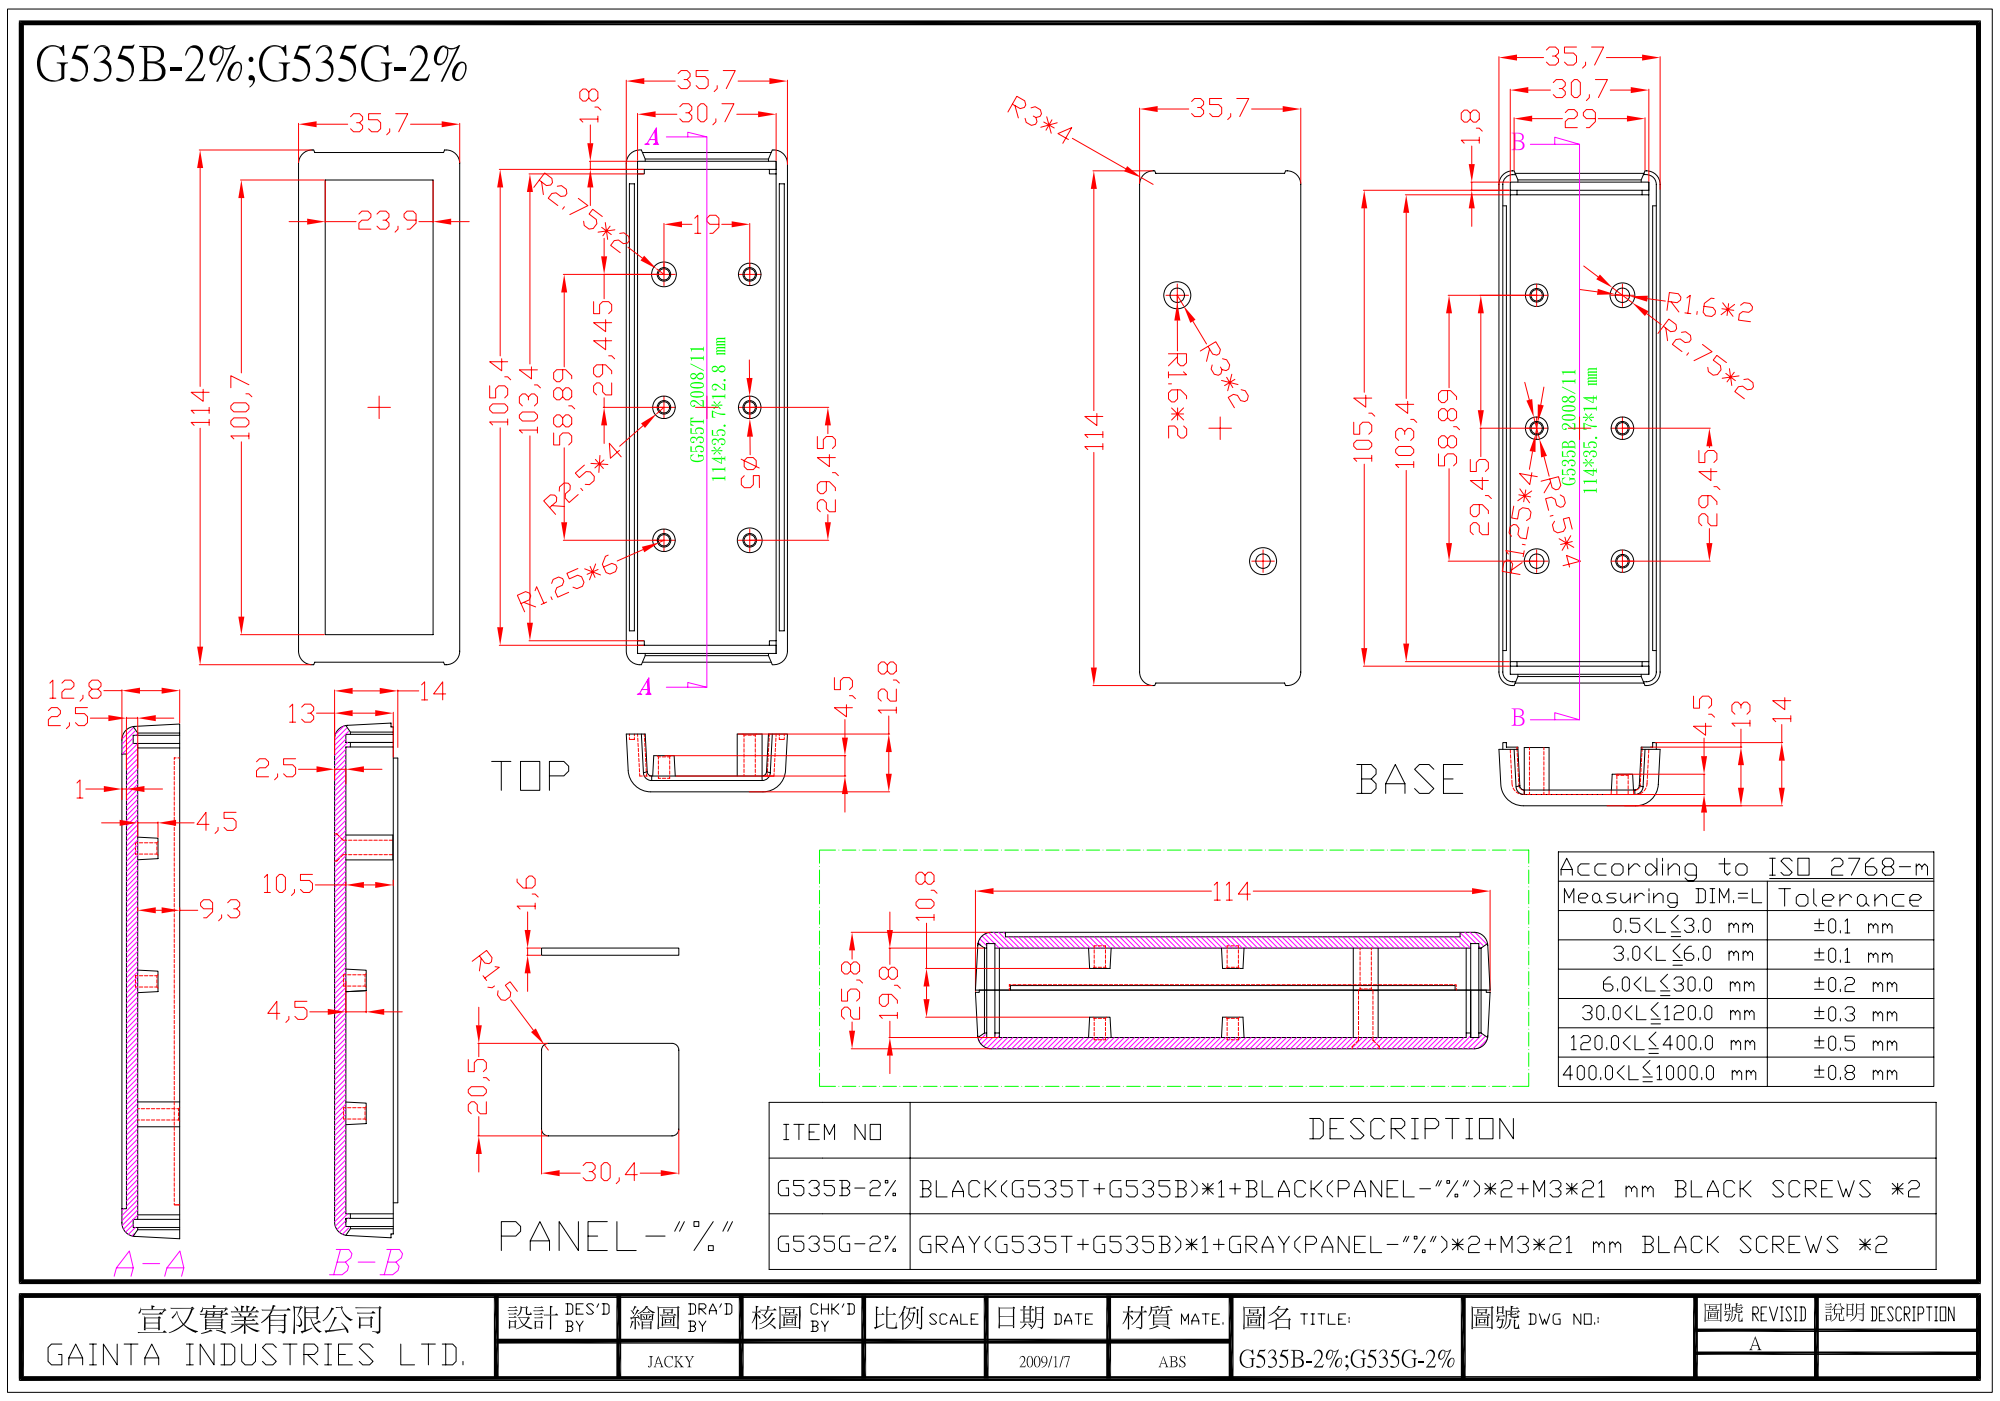
[picture p28: page 1]
