aaaaaaaalesha/wdt_agent/documentation/ПП. Сторожевой таймер. ИУ8-74 Александров.pdf

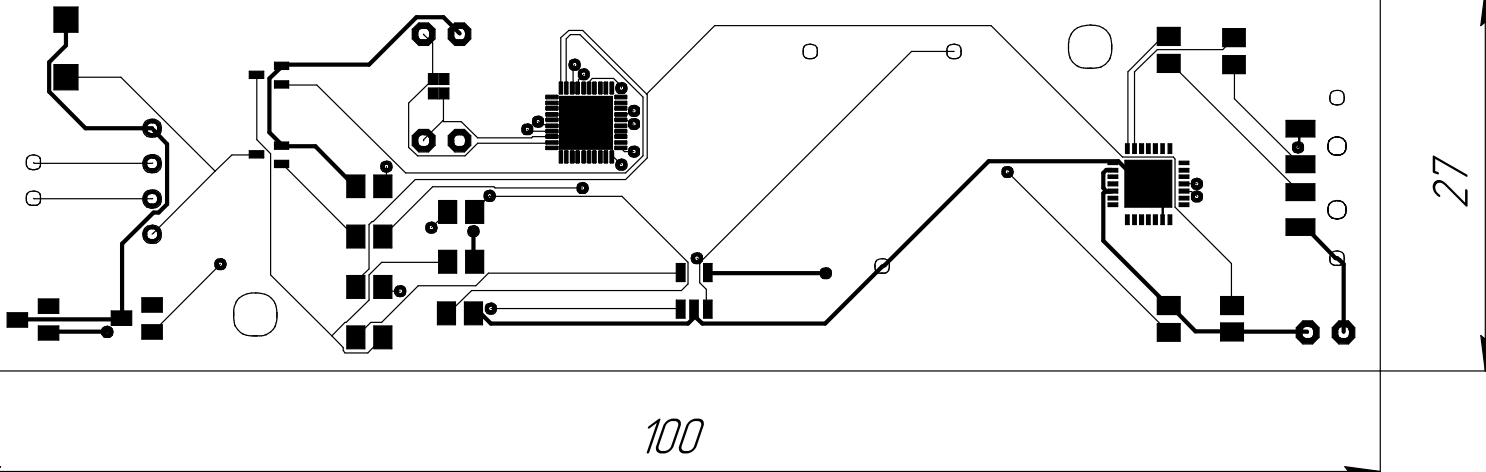
[picture p29: figure]
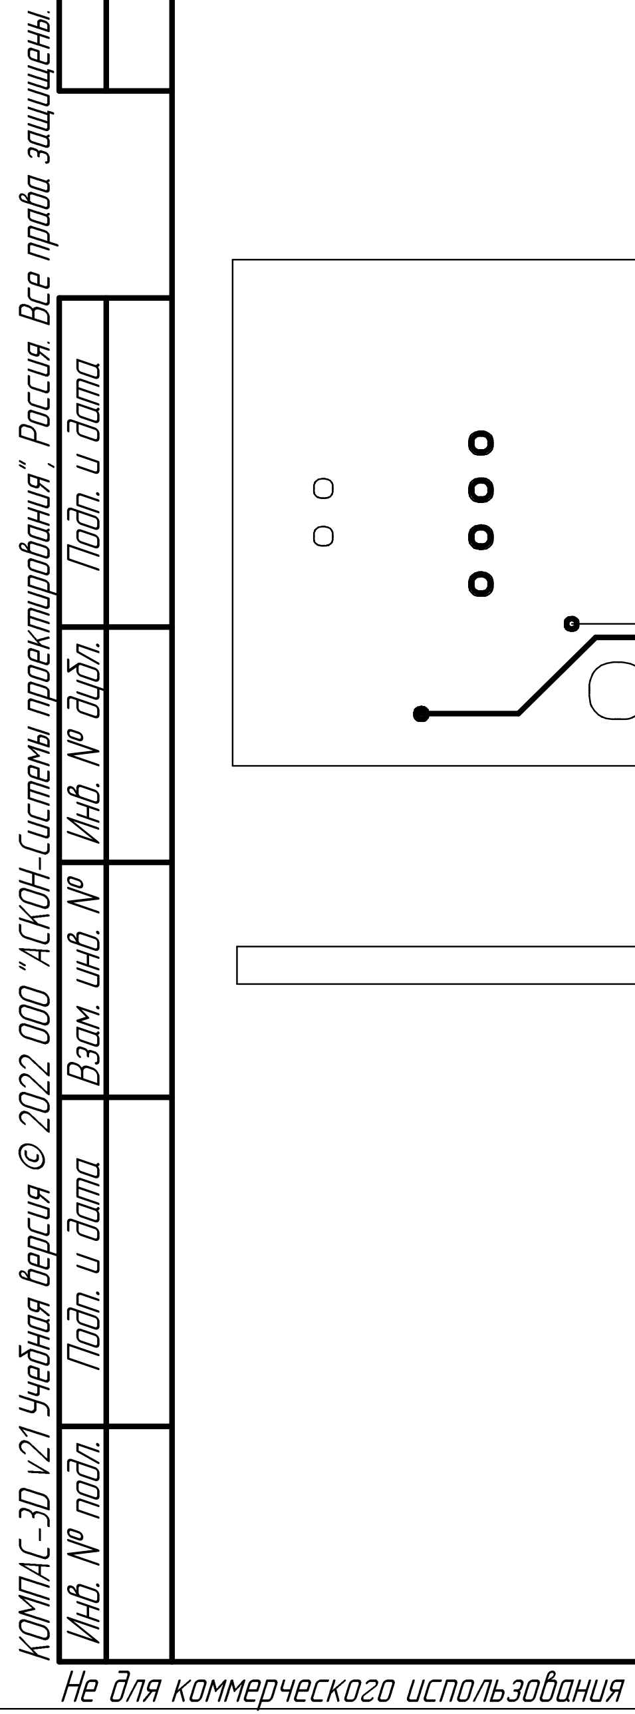
[picture p30: figure]

Unregistered Version - http://www.aidecad.com

# Верхний слой

Нижний слой | 1,6*
1. *Размеры для справок

2. Печатную плату изготовить комбинированным позитивным методом 3. Печатная плата должна соответствовать ГОСТ23752-19 4. Параметры отверстий указаны в таблице 1 (см. лист 2) 5. Расстояние между проводниками не менее 0.3 мм (4 класс точности) 6. Ширина проводников не менее 0.2 мм (4 класс точности) 7. Использование сухой паяльной маски зелёного цвета толщиной 20 мкм в

соответствии с ГОСТ Р 54849-2011.

### 8. Контактные площадки покрыть слоем припоя ПОС61 9. Маркировку проводить методом шелкографии краской желтого цвета

ТНПФТУ 29-02-359-70 шрифт 3 по НО.010.007
Приложение 1: Файлы GERBER - WDT_USB.zip

Rz40

Масса Масштаб
Изм. Лист № докум. Подп. Дата

Лит.

Разраб.
Пров.
Т.контр. | Лист | Листов

Н.контр.
Утв.

# МГТУ.000001.002 Сторожевой таймер

Рафиков А. Г. | Печатная плата Александров А. Н.

## МГТУ им. Н. Э. Баумана

Группа: ИУ8-74 Рафиков А. Г.

| | 1 2

2:1

Стеклотекстолит Инв. № подл. Подп. и дата Взам. инв. № Инв. № дубл. Подп. и дата | СФ-2-35Г-1,5мм ГОСТ10316-78 Справ. № Перв. примен.
Копировал | Формат A3

# Маркировочный слой

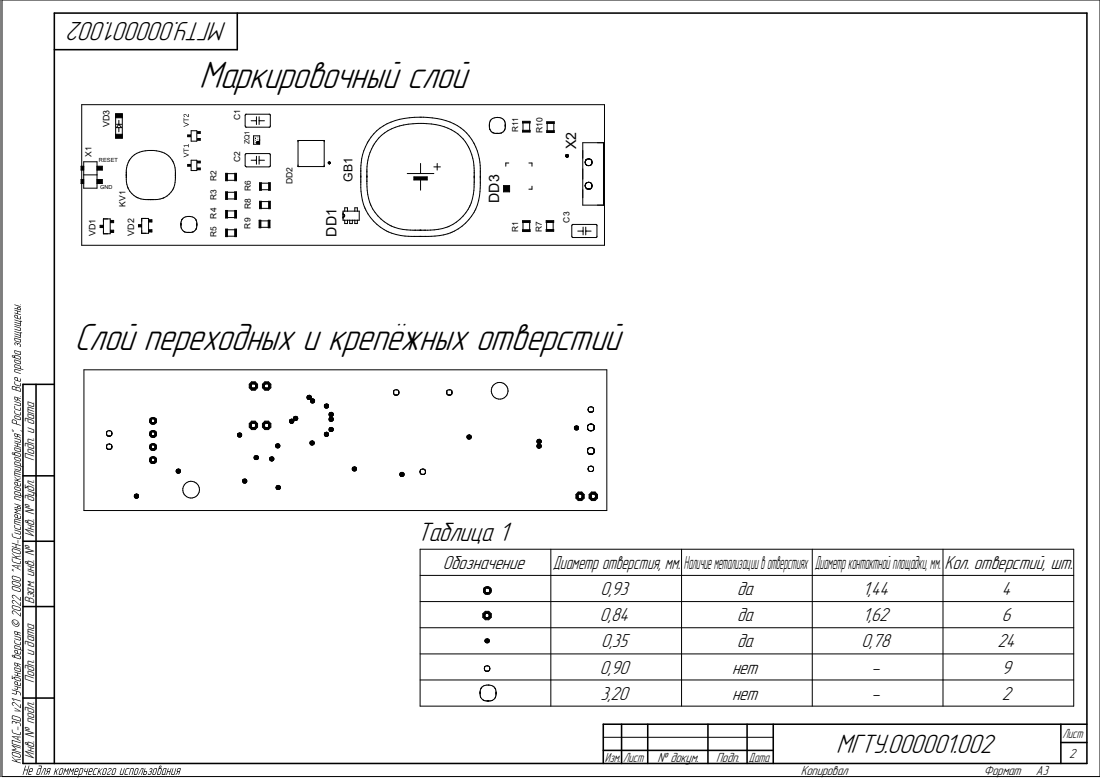
[picture p31: page 2]
нет нет; Таблица 1 RG C¹ C²; C³ DD¹ DD²; GB¹ KV¹; R¹ R¹¹; R¹⁰ R² R³ R⁴ R⁵; R⁷ R⁸ R⁹ VD¹; VD² VD³; ZQ¹ X¹; GND; RESET; DD³; Лист; Изм. Лист № докум. Подп. Дата Инв. № подл. Подп. и дата Взам. инв. № Инв. № дубл. Подп. и дата; МГТУ.000001.002; Копировал; Формат A3

Слой переходных и крепёжных отверстий

Обозначение Диаметр отверстия, мм.

Наличие метализации в отверстиях

Диаметр контактной площадки, мм.

Кол. отверстий, шт.
