aaaaaaaalesha/wdt_agent/documentation/СБ. Сторожевой таймер. ИУ8-74 Александров.pdf

100*

## Установка резисторов и конденсаторов

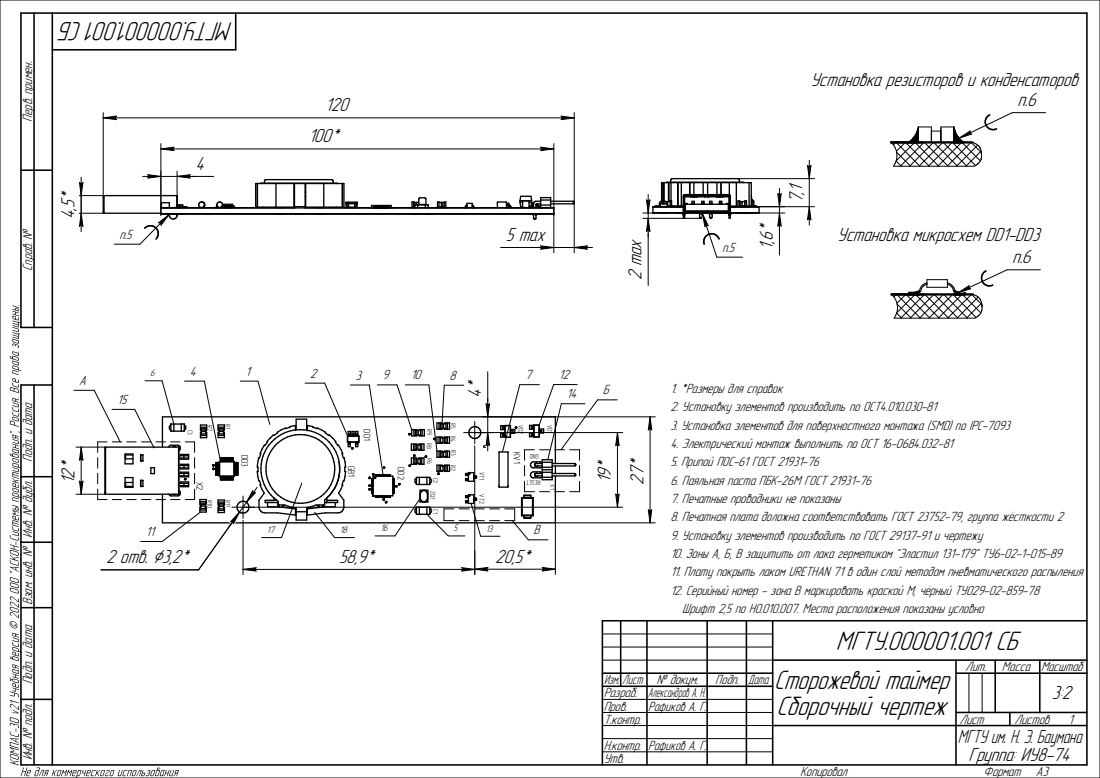
[picture p32: page 1]

1 Инв. № подл. Подп. и дата Взам. инв. № Инв. № дубл. Подп. и дата Справ. № Перв. примен.

1. *Размеры для справок
2. Установку элементов производить по ОСТ4.010.030-81
3. Установка элементов для поверхностного монтажа (SMD) по IPC-7093
4. Электрический монтаж выполнить по ОСТ 16-0684.032-81
5. Припой ПОС-61 ГОСТ 21931-76
6. Паяльная паста ПБК-26М ГОСТ 21931-76
7. Печатные проводники не показаны
8. Печатная плата доложна соответствовать ГОСТ 23752-79, группа жёсткости 2
9. Установку элементов производить по ГОСТ 29137-91 и чертежу
10. Зоны А, Б, В защитить от лака герметиком "Эластил 131-179" ТУ6-02-1-015-89
11. Плату покрыть лаком URETHAN 71 в один слой методом пневматического распыления
12. Серийный номер - зона В маркировать краской М, чёрный ТУ029-02-859-78
Шрифт 2,5 по НО.010.007. Места расположения показаны условно

МГТУ.000001.001 СБ

Сторожевой таймер | Лит. | Масса | Масштаб

Изм. Лист | № докум. | Подп. | Дата | | | | | 3:2
Разраб. | Рафиков А. Г. | | | Сборочный чертеж Александров А. Н.
Пров.
Т.контр. | | | | Лист | Листов
Н.контр. | Рафиков А. Г.
Утв.

МГТУ им. Н. Э. Баумана Группа: ИУ8-74
