aaaaaaaalesha/wdt_agent/documentation/Э1. Сторожевой таймер. ИУ8-74 Александров.pdf

# Автономный блок питания

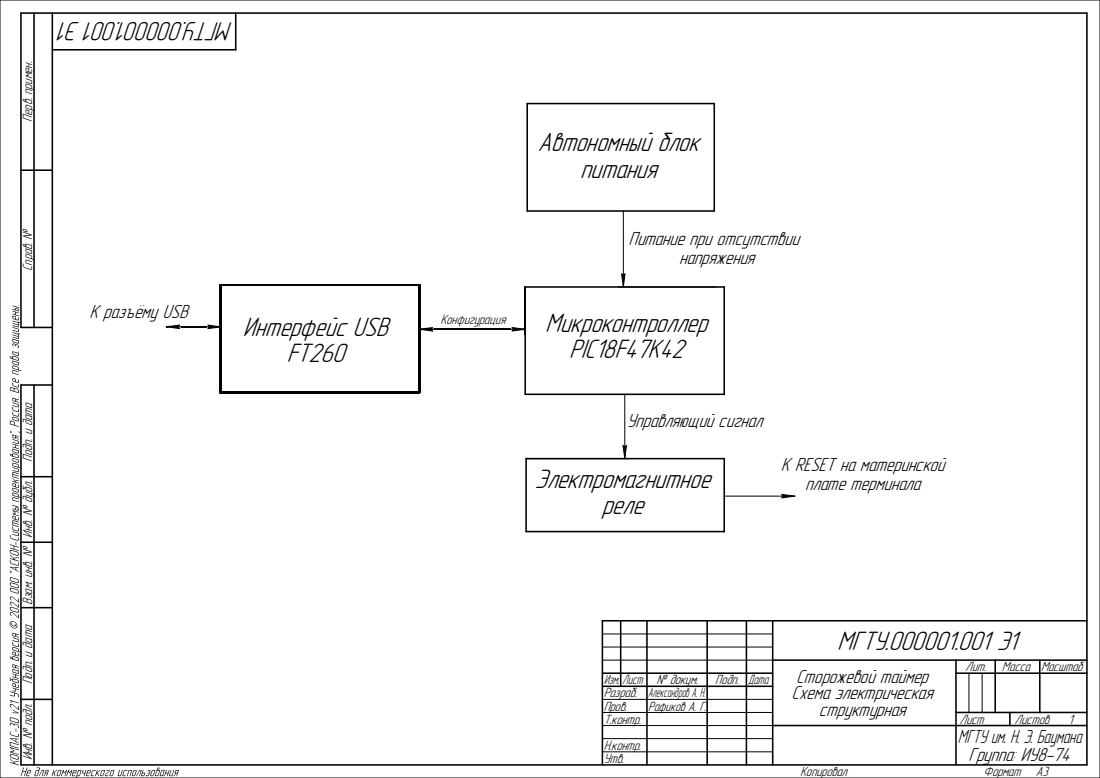
[picture p33: page 1]
Интерфейс USB FT260; Микроконтроллер PIC18F47K42; Конфигурация; Конфигурация К разъёму USB; Электромагнитное реле; Управляющий сигнал; МГТУ им. Н. Э. Баумана Инв. № подл. Подп. и дата Взам. инв. № Инв. № дубл. Подп. и дата; Группа: ИУ8-74 Справ. № Перв. примен.; Копировал; Формат A3

Питание при отсутствии
напряжения

Конфигурация К разъёму USB
К разъёму USB

К RESET на материнской
плате терминала

МГТУ.000001.001 Э1

Сторожевой таймер Схема электрическая | Лит. | Масса | Масштаб

Изм. Лист | № докум. | Подп. | Дата
Разраб. | Александров А. Н.
Пров. | | | | структурная Рафиков А. Г.
Т.контр. | | | | Лист | Листов 1
Н.контр.
Утв.
