aaaaaaaalesha/wdt_agent/(list of files, drawings)

Other design files:
pic_wdt/wachdog.pdsprj
